aakashvishcoder/fpgacarrierboard/bom_handsolder.csv

Qty | Value | Designator | Footprint | LCSC Part # (if any)
7 | 10uF | C1,C2,C3,C4,C21,C107,C108 | CP_Radial_D5.0mm_P2.00mm | C47344176
6 | 100nF | C5,C6,C7,C8,C22,C85 | C_Disc_D3.0mm_W2.0mm_P2.50mm | C5632430
4 | 3.3nF | C9,C10,C11,C12 | C_Disc_D3.0mm_W2.0mm_P2.50mm | C511575
8 | 22uF | C13,C14,C15,C16,C17,C18,C19,C20 | CP_Radial_D6.3mm_P2.50mm | C2835673
1 | 1nF | C23 | C_Disc_D3.0mm_W2.0mm_P2.50mm | C1624895
5 | 0.1uF | C88,C89,C106,C109,C110 | C_Disc_D3.0mm_W2.0mm_P2.50mm | C5632430
1 | 1uF | C90 | C_Disc_D3.0mm_W2.0mm_P2.50mm | C1646109
6 | LED | D1,D3,D4,D5,D6,D7 | LED_D3.0mm
1 | D_Zener | D2 | D_DO-41_SOD81_P10.16mm_Horizontal
1 | Polyfuse | F1 | FUSE-TH_L9.5-W3.5-P5.08-D0.8-S1.2
1 | Conn_01x06 | J1 | PinHeader_1x06_P2.54mm_Vertical
1 | HR911130C | J3 | RJ45-TH_HR911130C | C50933
1 | Conn_02x10_Odd_Even | J5 | PinHeader_2x10_P2.54mm_Vertical
1 | 2.49k | R1 | R_Axial_DIN0207_L6.3mm_D2.5mm_P10.16mm_Horizontal
5 | 10k | R2,R6,R39,R49,R50 | R_Axial_DIN0207_L6.3mm_D2.5mm_P10.16mm_Horizontal
1 | 24.9k | R3 | R_Axial_DIN0207_L6.3mm_D2.5mm_P10.16mm_Horizontal
1 | 20k | R4 | R_Axial_DIN0207_L6.3mm_D2.5mm_P10.16mm_Horizontal
1 | 4.99k | R5 | R_Axial_DIN0207_L6.3mm_D2.5mm_P10.16mm_Horizontal
1 | 49.9k | R7 | R_Axial_DIN0207_L6.3mm_D2.5mm_P10.16mm_Horizontal
1 | 16k | R8 | R_Axial_DIN0207_L6.3mm_D2.5mm_P10.16mm_Horizontal
6 | 100k | R9,R10,R11,R12,R15,R16 | R_Axial_DIN0207_L6.3mm_D2.5mm_P10.16mm_Horizontal
2 | 5.1k | R13,R14 | R_Axial_DIN0207_L6.3mm_D2.5mm_P10.16mm_Horizontal
19 | 4.7k | R18,R19,R20,R21,R22,R30,R31,R32,R33,R34,R35,R36,R37,R38,R40,R41,R42,R43,R44 | R_Axial_DIN0207_L6.3mm_D2.5mm_P10.16mm_Horizontal
4 | 1k | R23,R24,R25,R51 | R_Axial_DIN0207_L6.3mm_D2.5mm_P10.16mm_Horizontal
1 | 33 | R26 | R_Axial_DIN0207_L6.3mm_D2.5mm_P10.16mm_Horizontal
1 | 50 | R27 | R_Axial_DIN0207_L6.3mm_D2.5mm_P10.16mm_Horizontal
6 | 470 | R28,R45,R46,R47,R48,R53 | R_Axial_DIN0207_L6.3mm_D2.5mm_P10.16mm_Horizontal
1 | 330 | R52 | R_Axial_DIN0207_L6.3mm_D2.5mm_P10.16mm_Horizontal
3 | SW_Push | SW1,SW2,SW3 | SW_SPST_TL3342
