aakashvishcoder/fpgacarrierboard/bom_jlc.csv

Comment | Designator | Footprint | LCSC Part #
100uF | C24 | C_1210_3225Metric | C49066
47uF | C25,C26,C27,C28,C29 | C_1210_3225Metric | C2932477
4.7uF | C30,C31,C32,C33,C34,C35,C36,C37,C38,C39,C40,C41,C42,C43,C44,C45,C46,C103,C104,C105 | C_0805_2012Metric | C98195
0.47uF | C47,C48,C49,C50,C51,C52,C53,C54,C55,C56,C57,C58,C59,C60,C61,C62,C63,C64,C65,C66,C67,C68,C69,C70,C71,C72,C73,C74,C75,C76,C77,C78 | C_0603_1608Metric | C1623
4.7uF | C79,C80 | C_0603_1608Metric | C107368
0.1uF | C81,C82,C83,C84,C86,C87,C91,C92,C93,C94,C95,C96,C97,C98,C99,C100,C101,C102,C111,C112,C113,C114 | C_0603_1608Metric | C14663
FerriteBead | FB1,FB2,FB3,FB4,FB5,FB6,FB7 | L_0603_1608Metric | C19330
Conn_Coaxial | J2 | SMA_Amphenol_132134-10_Vertical | C2693814
SFPK-SL | J4 | SAMTEC_SFPK-SL | C20691304
2.2uH | L1,L2,L3,L4 | IND-SMD_L4.5-W4.1_SRP4020TA | C719179
OB2EL89CLIB112YLC-125M | OSC1 | OSC-SMD_6P-L3.2-W2.5-BL-1 | C7425465
100 | R17 | R_0603_1608Metric | C2906981
2.49k | R29 | R_0603_1608Metric | C2930072
TPS62130A | U1,U2,U3,U4 | VQFN-16-1EP_3x3mm_P0.5mm_EP1.68x1.68mm | C337502
TPS2592xx | U5 | VSON-10-1EP_3x3mm_P0.5mm_EP1.65x2.4mm | C527680
XC7A35T-FGG484 | U6 | Xilinx_FGG484 | C6934285
W25Q128JVS | U7 | SOIC-8_5.3x5.3mm_P1.27mm | C97521
RTL8211E-VB-CG | U8 | QFN-48_L6.0-W6.0-P0.40-BL-EP3.8 | C90735
TYPE-C 6P | USB1 | TYPE-C-SMD_TYPE-C-6P_1 | C456012
OT322550MJBA4SL | Y1 | OSC-SMD_4P-L3.2-W2.5-BL | C717684
OT322525MJBA4SL | Y3 | OSC-SMD_4P-L3.2-W2.5-BL | C669088
