aakashvishcoder/fpgacarrierboard/bom_cli.csv

Reference | Value | Footprint | Qty | LCSC
C1-C4,C21,C107,C108 | 10uF | Capacitor_THT:CP_Radial_D5.0mm_P2.00mm | 7 | C47344176
C5-C8,C22,C85 | 100nF | Capacitor_THT:C_Disc_D3.0mm_W2.0mm_P2.50mm | 6 | C5632430
C9-C12 | 3.3nF | Capacitor_THT:C_Disc_D3.0mm_W2.0mm_P2.50mm | 4 | C511575
C13-C20 | 22uF | Capacitor_THT:CP_Radial_D6.3mm_P2.50mm | 8 | C2835673
C23 | 1nF | Capacitor_THT:C_Disc_D3.0mm_W2.0mm_P2.50mm | 1 | C1624895
C24 | 100uF | Capacitor_SMD:C_1210_3225Metric | 1 | C49066
C25-C29 | 47uF | Capacitor_SMD:C_1210_3225Metric | 5 | C2932477
C30-C46,C103-C105 | 4.7uF | Capacitor_SMD:C_0805_2012Metric | 20 | C98195
C47-C78 | 0.47uF | Capacitor_SMD:C_0603_1608Metric | 32 | C1623
C79,C80 | 4.7uF | Capacitor_SMD:C_0603_1608Metric | 2 | C107368
C81-C84,C86,C87,C91-C102,C111-C114 | 0.1uF | Capacitor_SMD:C_0603_1608Metric | 22 | C14663
C88,C89,C106,C109,C110 | 0.1uF | Capacitor_THT:C_Disc_D3.0mm_W2.0mm_P2.50mm | 5 | C5632430
C90 | 1uF | Capacitor_THT:C_Disc_D3.0mm_W2.0mm_P2.50mm | 1 | C1646109
D1,D3-D6 | LED | LED_THT:LED_D3.0mm | 5
D2 | D_Zener | Diode_THT:D_DO-41_SOD81_P10.16mm_Horizontal | 1
F1 | Polyfuse | easyeda:FUSE-TH_L9.5-W3.5-P5.08-D0.8-S1.2 | 1
FB1-FB7 | FerriteBead | Inductor_SMD:L_0603_1608Metric | 7 | C19330
J1 | Conn_01x06 | Connector_PinHeader_2.54mm:PinHeader_1x06_P2.54mm_Vertical | 1
J2 | Conn_Coaxial | Connector_Coaxial:SMA_Amphenol_132134-10_Vertical | 1 | C2693814
J3 | HR911130C | easyeda:RJ45-TH_HR911130C | 1 | C50933
J4 | SFPK-SL | samtec:SAMTEC_SFPK-SL | 1 | C20691304
J5 | Conn_02x10_Odd_Even | Connector_PinHeader_2.54mm:PinHeader_2x10_P2.54mm_Vertical | 1
L1-L4 | 2.2uH | easyeda:IND-SMD_L4.5-W4.1_SRP4020TA | 4 | C719179
OSC1 | OB2EL89CLIB112YLC-125M | easyeda:OSC-SMD_6P-L3.2-W2.5-BL-1 | 1 | C7425465
R1 | 2.49k | Resistor_THT:R_Axial_DIN0207_L6.3mm_D2.5mm_P10.16mm_Horizontal | 1
R2,R6,R39,R49,R50 | 10k | Resistor_THT:R_Axial_DIN0207_L6.3mm_D2.5mm_P10.16mm_Horizontal | 5
R3 | 24.9k | Resistor_THT:R_Axial_DIN0207_L6.3mm_D2.5mm_P10.16mm_Horizontal | 1
R4 | 20k | Resistor_THT:R_Axial_DIN0207_L6.3mm_D2.5mm_P10.16mm_Horizontal | 1
R5 | 4.99k | Resistor_THT:R_Axial_DIN0207_L6.3mm_D2.5mm_P10.16mm_Horizontal | 1
R7 | 49.9k | Resistor_THT:R_Axial_DIN0207_L6.3mm_D2.5mm_P10.16mm_Horizontal | 1
R8 | 16k | Resistor_THT:R_Axial_DIN0207_L6.3mm_D2.5mm_P10.16mm_Horizontal | 1
R9-R12,R15,R16 | 100k | Resistor_THT:R_Axial_DIN0207_L6.3mm_D2.5mm_P10.16mm_Horizontal | 6
R13,R14 | 5.1k | Resistor_THT:R_Axial_DIN0207_L6.3mm_D2.5mm_P10.16mm_Horizontal | 2
R17 | 100 | Resistor_SMD:R_0603_1608Metric | 1 | C2906981
R18-R22,R30-R38,R40-R44,R51 | 4.7k | Resistor_THT:R_Axial_DIN0207_L6.3mm_D2.5mm_P10.16mm_Horizontal | 20
R23-R25 | 1k | Resistor_THT:R_Axial_DIN0207_L6.3mm_D2.5mm_P10.16mm_Horizontal | 3
R26 | 33 | Resistor_THT:R_Axial_DIN0207_L6.3mm_D2.5mm_P10.16mm_Horizontal | 1
R27 | 50 | Resistor_THT:R_Axial_DIN0207_L6.3mm_D2.5mm_P10.16mm_Horizontal | 1
R28,R45-R48 | 470 | Resistor_THT:R_Axial_DIN0207_L6.3mm_D2.5mm_P10.16mm_Horizontal | 5
R29 | 2.49k | Resistor_SMD:R_0603_1608Metric | 1 | C2930072
SW1-SW3 | SW_Push | Button_Switch_SMD:SW_SPST_TL3342 | 3
TP1 | 1V0_TP | TestPoint:TestPoint_THTPad_D1.5mm_Drill0.7mm | 1
TP2 | 1V8_TP | TestPoint:TestPoint_THTPad_D1.5mm_Drill0.7mm | 1
TP3 | 1V2_TP | TestPoint:TestPoint_THTPad_D1.5mm_Drill0.7mm | 1
TP4 | 3V3_TP | TestPoint:TestPoint_THTPad_D1.5mm_Drill0.7mm | 1
TP5 | TestPoint | TestPoint:TestPoint_THTPad_D1.5mm_Drill0.7mm | 1
U1-U4 | TPS62130A | Package_DFN_QFN:VQFN-16-1EP_3x3mm_P0.5mm_EP1.68x1.68mm | 4 | C337502
U5 | TPS2592xx | Package_SON:VSON-10-1EP_3x3mm_P0.5mm_EP1.65x2.4mm | 1 | C527680
U6 | XC7A35T-FGG484 | Package_BGA:Xilinx_FGG484 | 1 | C6934285
U7 | W25Q128JVS | Package_SO:SOIC-8_5.3x5.3mm_P1.27mm | 1 | C97521
U8 | RTL8211E-VB-CG | easyeda:QFN-48_L6.0-W6.0-P0.40-BL-EP3.8 | 1 | C90735
USB1 | TYPE-C 6P | easyeda:TYPE-C-SMD_TYPE-C-6P_1 | 1 | C456012
Y1 | OT322550MJBA4SL | easyeda:OSC-SMD_4P-L3.2-W2.5-BL | 1 | C717684
Y3 | OT322525MJBA4SL | easyeda:OSC-SMD_4P-L3.2-W2.5-BL | 1 | C669088
