aakashvishcoder/fpgacarrierboard/fpgacarrierboard.kicad_pcb

## KiCad design fpgacarrierboard.kicad_pcb (2026-10-16)

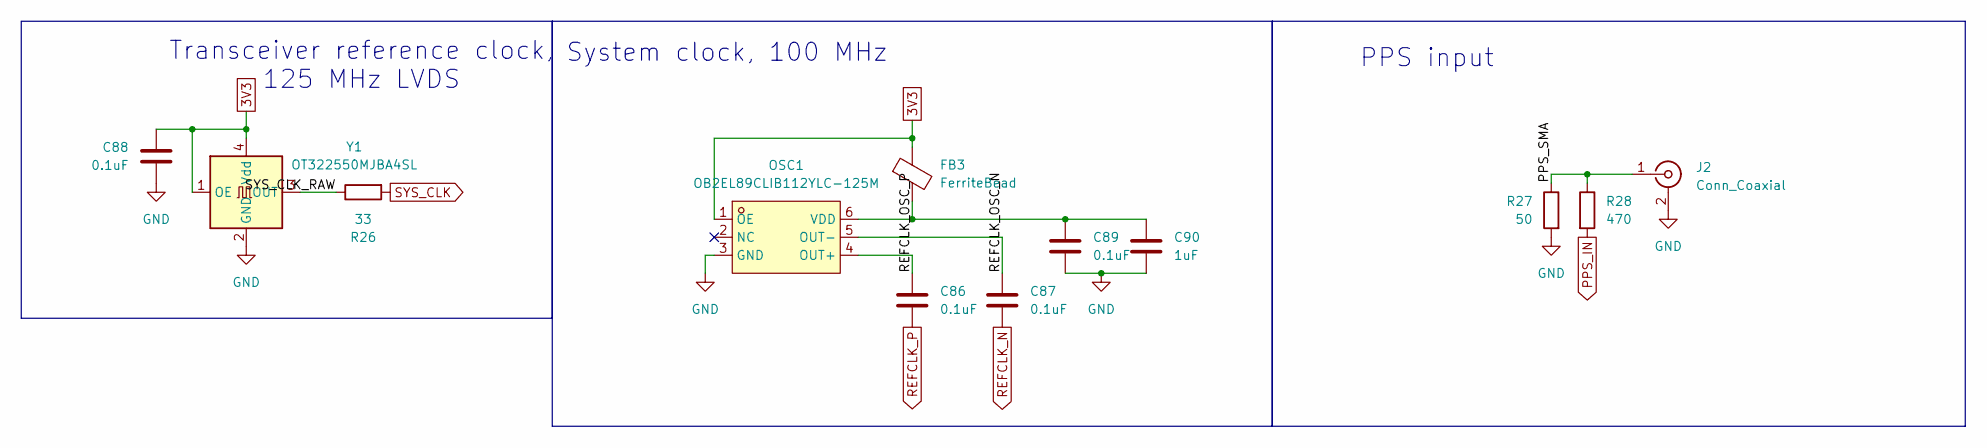
[picture p1: schematic clocks.kicad_sch]

Parts:
C86, C87: 0.1uF; C_0603_1608Metric; LCSC Part C14663
C88, C89: 0.1uF; C_Disc_D3.0mm_W2.0mm_P2.50mm; LCSC Part C5632430
C90: 1uF; C_Disc_D3.0mm_W2.0mm_P2.50mm; LCSC Part C1646109
FB3: FerriteBead; L_0603_1608Metric; LCSC Part C19330
J2: Conn_Coaxial; SMA_Amphenol_132134-10_Vertical; LCSC Part C2693814
OSC1: OB2EL89CLIB112YLC-125M; OSC-SMD_6P-L3.2-W2.5-BL-1; MPN OB2EL89CLIB112YLC-125M; LCSC Part C7425465
R26: 33; R_Axial_DIN0207_L6.3mm_D2.5mm_P10.16mm_Horizontal
R27: 50; R_Axial_DIN0207_L6.3mm_D2.5mm_P10.16mm_Horizontal
R28: 470; R_Axial_DIN0207_L6.3mm_D2.5mm_P10.16mm_Horizontal
Y1: OT322550MJBA4SL; OSC-SMD_4P-L3.2-W2.5-BL; LCSC Part C717684

Connections:
3V3: C88.1, FB3.1, OSC1.1 (OE), Y1.1 (OE), Y1.4 (Vdd); also elsewhere on the board
/Clocks/PPS_SMA: J2.1 (In), R27.1, R28.1
/Clocks/REFCLK_OSC_N: C87.1, OSC1.5 (OUT-)
/Clocks/REFCLK_OSC_P: C86.1, OSC1.4 (OUT+)
/Clocks/SYS_CLK_RAW: R26.1, Y1.3 (OUT)
GND: C88.2, C89.2, C90.2, J2.2 (Ext), OSC1.3 (GND), R27.2, Y1.2 (GND); also elsewhere on the board
unnamed: C89.1, C90.1, FB3.2, OSC1.6 (VDD)
PPS_IN: R28.2; also elsewhere on the board
REFCLK_N: C87.2; also elsewhere on the board
REFCLK_P: C86.2; also elsewhere on the board
SYS_CLK: R26.2; also elsewhere on the board

Notes on the sheet:
System clock, 100 MHz
PPS input
Transceiver reference clock, 125 MHz LVDS

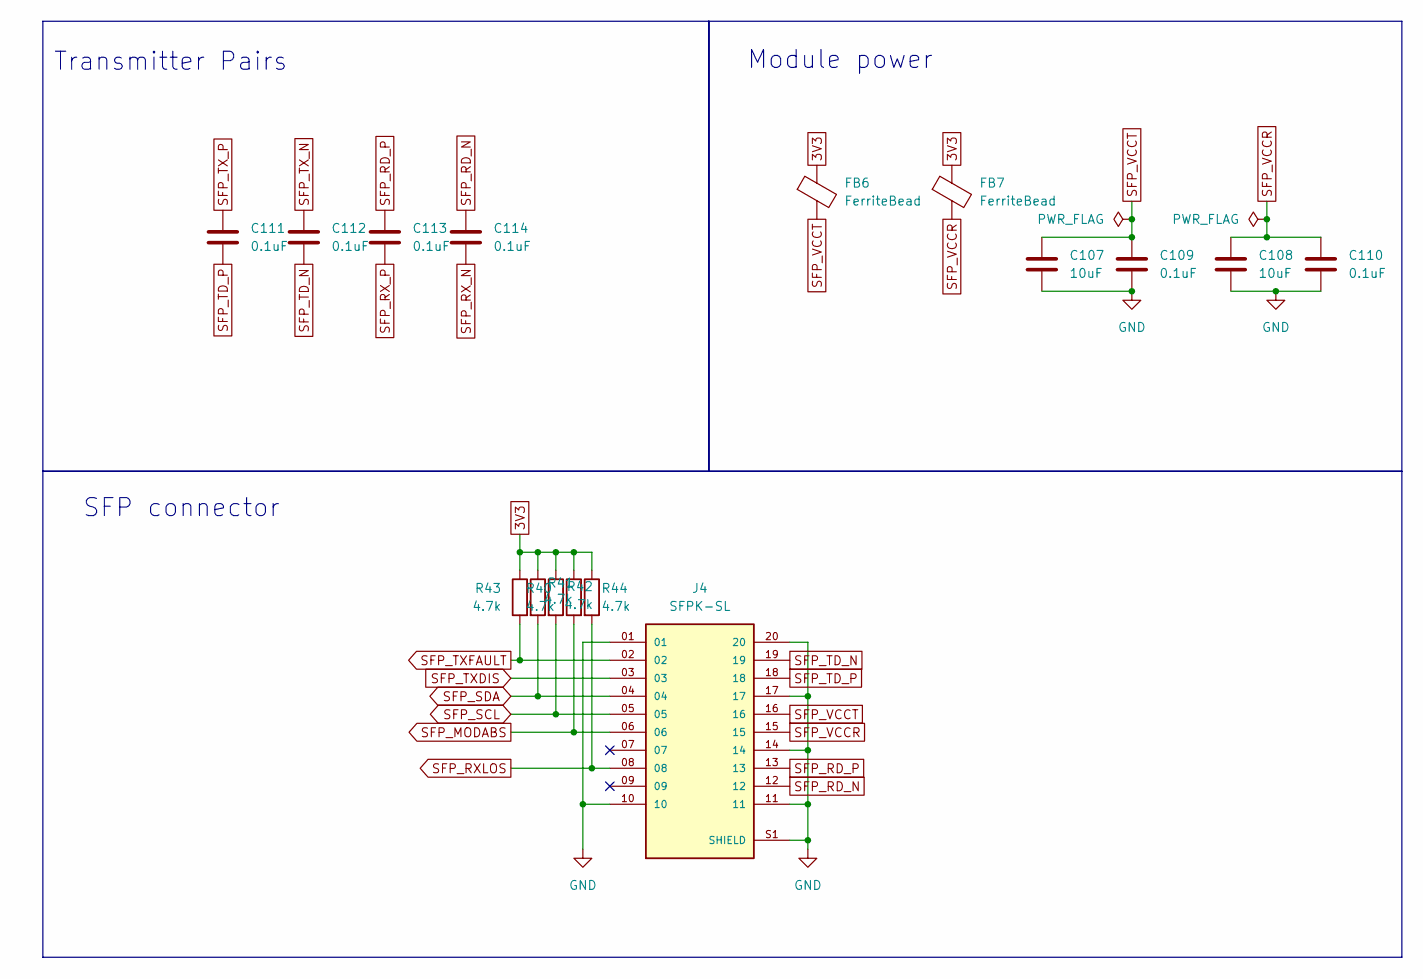
[picture p2: schematic sfplane.kicad_sch]

Parts:
C107, C108: 10uF; CP_Radial_D5.0mm_P2.00mm; LCSC Part C47344176
C109, C110: 0.1uF; C_Disc_D3.0mm_W2.0mm_P2.50mm; LCSC Part C5632430
C111, C112, C113, C114: 0.1uF; C_0603_1608Metric; LCSC Part C14663
FB6, FB7: FerriteBead; L_0603_1608Metric; LCSC Part C19330
J4: SFPK-SL; SAMTEC_SFPK-SL; PARTREV H; LCSC Part C20691304
R40, R41, R42, R43, R44: 4.7k; R_Axial_DIN0207_L6.3mm_D2.5mm_P10.16mm_Horizontal

Connections:
3V3: FB6.1, FB7.1, R40.1, R41.1, R42.1, R43.1, R44.1; also elsewhere on the board
GND: C107.2, C108.2, C109.2, C110.2, J4.01, J4.10, J4.11, J4.14, J4.17, J4.20, J4.S1 (SHIELD), J4.S2 (SHIELD), J4.S3 (SHIELD), J4.S4 (SHIELD), J4.S5 (SHIELD), J4.S6 (SHIELD), J4.S7 (SHIELD), J4.S8 (SHIELD), J4.S9 (SHIELD), J4.S10 (SHIELD), J4.S11 (SHIELD), J4.S12 (SHIELD), J4.S13 (SHIELD), J4.S14 (SHIELD), J4.S15 (SHIELD), J4.S16 (SHIELD), J4.S17 (SHIELD); also elsewhere on the board
SFP_MODABS: J4.06, R42.2; also elsewhere on the board
SFP_RD_N: C114.1, J4.12
SFP_RD_P: C113.1, J4.13
SFP_RXLOS: J4.08, R44.2; also elsewhere on the board
SFP_RX_N: C114.2; also elsewhere on the board
SFP_RX_P: C113.2; also elsewhere on the board
SFP_SCL: J4.05, R41.2; also elsewhere on the board
SFP_SDA: J4.04, R40.2; also elsewhere on the board
SFP_TD_N: C112.2, J4.19
SFP_TD_P: C111.2, J4.18
SFP_TXDIS: J4.03; also elsewhere on the board
SFP_TXFAULT: J4.02, R43.2; also elsewhere on the board
SFP_TX_N: C112.1; also elsewhere on the board
SFP_TX_P: C111.1; also elsewhere on the board
SFP_VCCR: C108.1, C110.1, FB7.2, J4.15
SFP_VCCT: C107.1, C109.1, FB6.2, J4.16

Notes on the sheet:
Transmitter Pairs
SFP connector
Module power

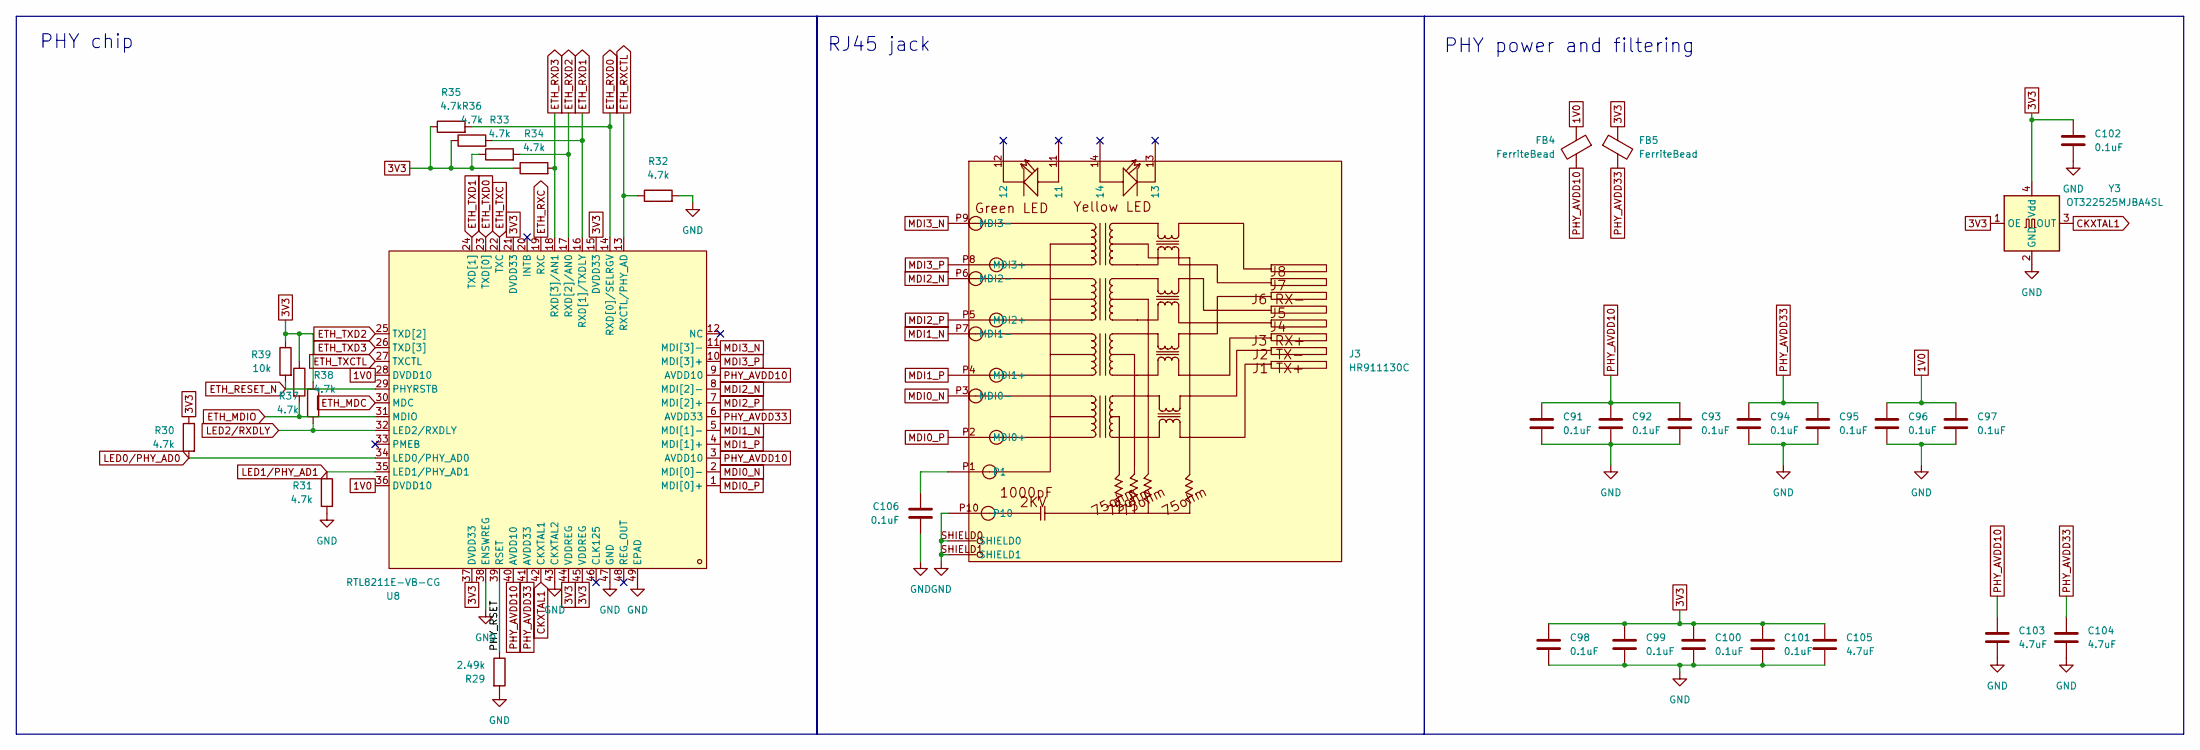
[picture p3: schematic ethernet1g.kicad_sch]

Parts:
C91, C92, C93, C94, C95, C96, C97, C98, C99, C100, C101, C102: 0.1uF; C_0603_1608Metric; LCSC Part C14663
C103, C104, C105: 4.7uF; C_0805_2012Metric; LCSC Part C98195
C106: 0.1uF; C_Disc_D3.0mm_W2.0mm_P2.50mm; LCSC Part C5632430
FB4, FB5: FerriteBead; L_0603_1608Metric; LCSC Part C19330
J3: HR911130C; RJ45-TH_HR911130C; MPN HR911130C; LCSC Part C50933
R29: 2.49k; R_0603_1608Metric; LCSC Part C2930072
R30, R31, R32, R33, R34, R35, R36, R37, R38: 4.7k; R_Axial_DIN0207_L6.3mm_D2.5mm_P10.16mm_Horizontal
R39: 10k; R_Axial_DIN0207_L6.3mm_D2.5mm_P10.16mm_Horizontal
U8: RTL8211E-VB-CG; QFN-48_L6.0-W6.0-P0.40-BL-EP3.8; MPN RTL8211E-VB-CG; LCSC Part C90735
Y3: OT322525MJBA4SL; OSC-SMD_4P-L3.2-W2.5-BL; LCSC Part C669088

Connections:
1V0: C96.1, C97.1, FB4.1, U8.28 (DVDD10), U8.36 (DVDD10); also elsewhere on the board
3V3: C98.1, C99.1, C100.1, C101.1, C102.1, C105.1, FB5.1, R30.1, R33.1, R34.1, R35.1, R36.1, R37.1, R38.1, R39.1, U8.15 (DVDD33), U8.21 (DVDD33), U8.37 (DVDD33), U8.44 (VDDREG), U8.45 (VDDREG), Y3.1 (OE), Y3.4 (Vdd); also elsewhere on the board
/Ethernet_1G/PHY_RSET: R29.1, U8.39 (RSET)
CKXTAL1: U8.42 (CKXTAL1), Y3.3 (OUT)
ETH_MDC: U8.30 (MDC); also elsewhere on the board
ETH_MDIO: R38.2, U8.31 (MDIO); also elsewhere on the board
ETH_RESET_N: R39.2, U8.29 (PHYRSTB); also elsewhere on the board
ETH_RXC: U8.19 (RXC); also elsewhere on the board
ETH_RXCTL: R32.1, U8.13 (RXCTL/PHY_AD); also elsewhere on the board
ETH_RXD0: R35.2, U8.14 (RXD[0]/SELRGV); also elsewhere on the board
ETH_RXD1: R36.2, U8.16 (RXD[1]/TXDLY); also elsewhere on the board
ETH_RXD2: R33.2, U8.17 (RXD[2]/AN0); also elsewhere on the board
ETH_RXD3: R34.2, U8.18 (RXD[3]/AN1); also elsewhere on the board
ETH_TXC: U8.22 (TXC); also elsewhere on the board
ETH_TXCTL: U8.27 (TXCTL); also elsewhere on the board
ETH_TXD0: U8.23 (TXD[0]); also elsewhere on the board
ETH_TXD1: U8.24 (TXD[1]); also elsewhere on the board
ETH_TXD2: U8.25 (TXD[2]); also elsewhere on the board
ETH_TXD3: U8.26 (TXD[3]); also elsewhere on the board
GND: C91.2, C92.2, C93.2, C94.2, C95.2, C96.2, C97.2, C98.2, C99.2, C100.2, C101.2, C102.2, C103.2, C104.2, C105.2, C106.2, J3.P10, J3.SHIELD0, J3.SHIELD1, R29.2, R31.2, R32.2, U8.38 (ENSWREG), U8.43 (CKXTAL2), U8.47 (GND), U8.49 (EPAD), Y3.2 (GND); also elsewhere on the board
LED0/PHY_AD0: R30.2, U8.34 (LED0/PHY_AD0)
LED1/PHY_AD1: R31.1, U8.35 (LED1/PHY_AD1)
LED2/RXDLY: R37.2, U8.32 (LED2/RXDLY)
MDI0_N: J3.P3 (MDI0-), U8.2 (MDI[0]-)
MDI0_P: J3.P2 (MDI0+), U8.1 (MDI[0]+)
MDI1_N: J3.P7 (MDI1-), U8.5 (MDI[1]-)
MDI1_P: J3.P4 (MDI1+), U8.4 (MDI[1]+)
MDI2_N: J3.P6 (MDI2-), U8.8 (MDI[2]-)
MDI2_P: J3.P5 (MDI2+), U8.7 (MDI[2]+)
MDI3_N: J3.P9 (MDI3-), U8.11 (MDI[3]-)
MDI3_P: J3.P8 (MDI3+), U8.10 (MDI[3]+)
unnamed: C106.1, J3.P1
PHY_AVDD10: C91.1, C92.1, C93.1, C103.1, FB4.2, U8.3 (AVDD10), U8.9 (AVDD10), U8.40 (AVDD10)
PHY_AVDD33: C94.1, C95.1, C104.1, FB5.2, U8.6 (AVDD33), U8.41 (AVDD33)

Notes on the sheet:
PHY chip
PHY power and filtering
RJ45 jack

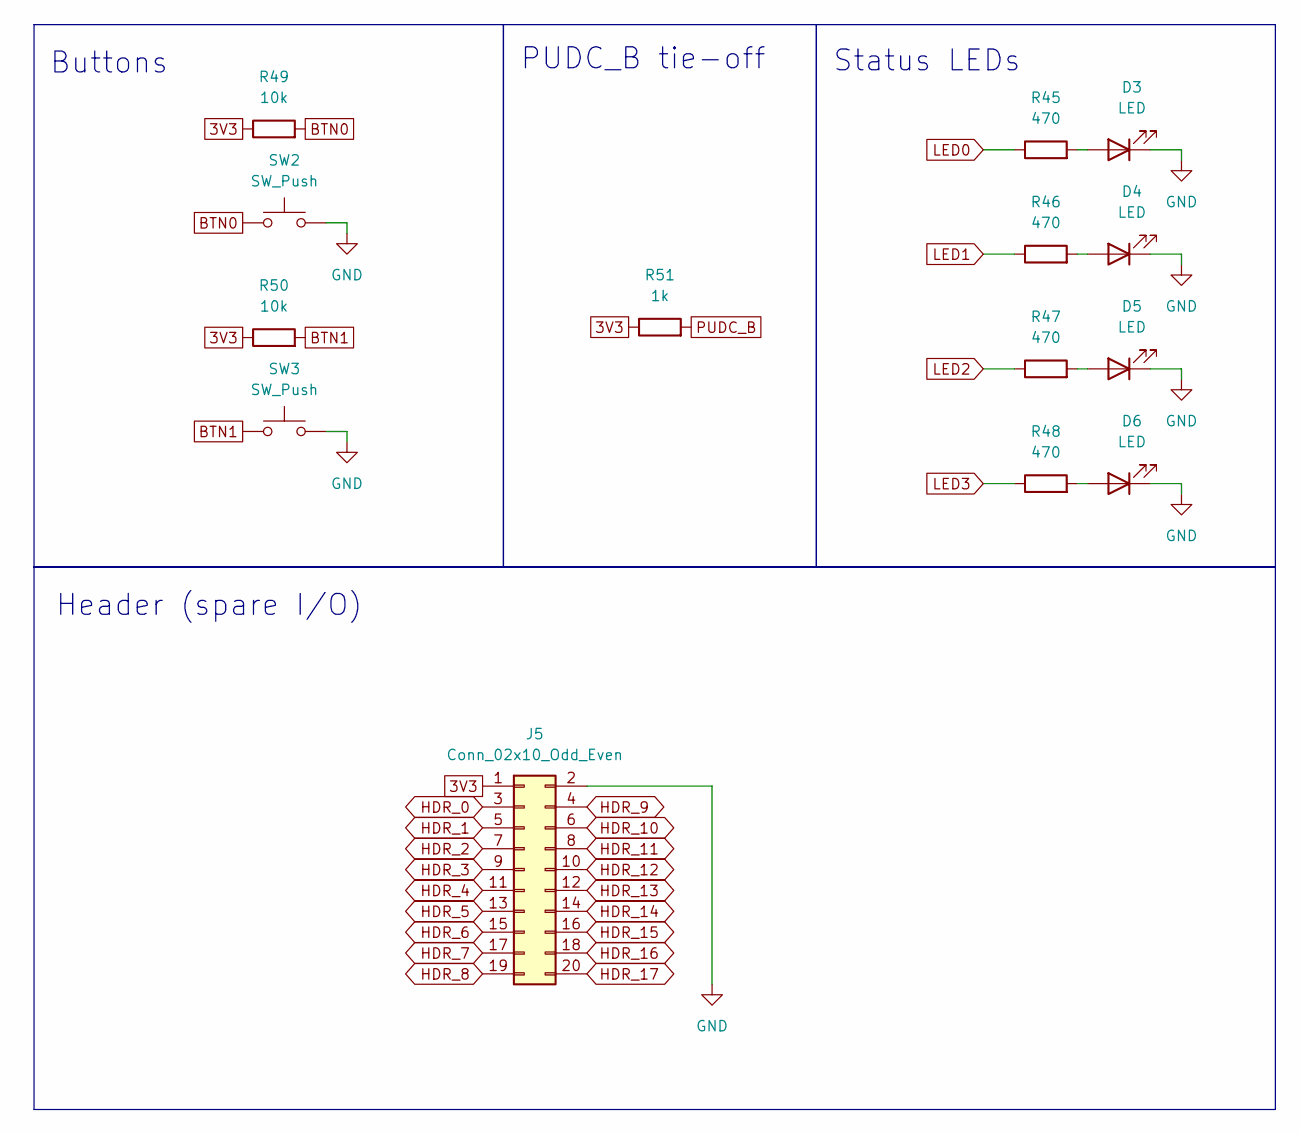
[picture p4: schematic iobreakout.kicad_sch]

Parts:
D3, D4, D5, D6: LED; LED_D3.0mm
J5: Conn_02x10_Odd_Even; PinHeader_2x10_P2.54mm_Vertical
R45, R46, R47, R48: 470; R_Axial_DIN0207_L6.3mm_D2.5mm_P10.16mm_Horizontal
R49, R50: 10k; R_Axial_DIN0207_L6.3mm_D2.5mm_P10.16mm_Horizontal
R51: 1k; R_Axial_DIN0207_L6.3mm_D2.5mm_P10.16mm_Horizontal
SW2, SW3: SW_Push; SW_SPST_TL3342

Connections:
3V3: J5.1, R49.1, R50.1, R51.1; also elsewhere on the board
BTN0: R49.2, SW2.1; also elsewhere on the board
BTN1: R50.2, SW3.1; also elsewhere on the board
GND: D3.1 (K), D4.1 (K), D5.1 (K), D6.1 (K), J5.2, SW2.2, SW3.2; also elsewhere on the board
HDR_0: J5.3; also elsewhere on the board
HDR_1: J5.5; also elsewhere on the board
HDR_2: J5.7; also elsewhere on the board
HDR_3: J5.9; also elsewhere on the board
HDR_4: J5.11; also elsewhere on the board
HDR_5: J5.13; also elsewhere on the board
HDR_6: J5.15; also elsewhere on the board
HDR_7: J5.17; also elsewhere on the board
HDR_8: J5.19; also elsewhere on the board
HDR_9: J5.4; also elsewhere on the board
HDR_10: J5.6; also elsewhere on the board
HDR_11: J5.8; also elsewhere on the board
HDR_12: J5.10; also elsewhere on the board
HDR_13: J5.12; also elsewhere on the board
HDR_14: J5.14; also elsewhere on the board
HDR_15: J5.16; also elsewhere on the board
HDR_16: J5.18; also elsewhere on the board
HDR_17: J5.20; also elsewhere on the board
LED0: R45.1; also elsewhere on the board
LED1: R46.1; also elsewhere on the board
LED2: R47.1; also elsewhere on the board
LED3: R48.1; also elsewhere on the board
unnamed: D3.2 (A), R45.2
unnamed: D4.2 (A), R46.2
unnamed: D5.2 (A), R47.2
unnamed: D6.2 (A), R48.2
PUDC_B: R51.2; also elsewhere on the board

Notes on the sheet:
Buttons
PUDC_B tie-off
Status LEDs
Header (spare I/O)

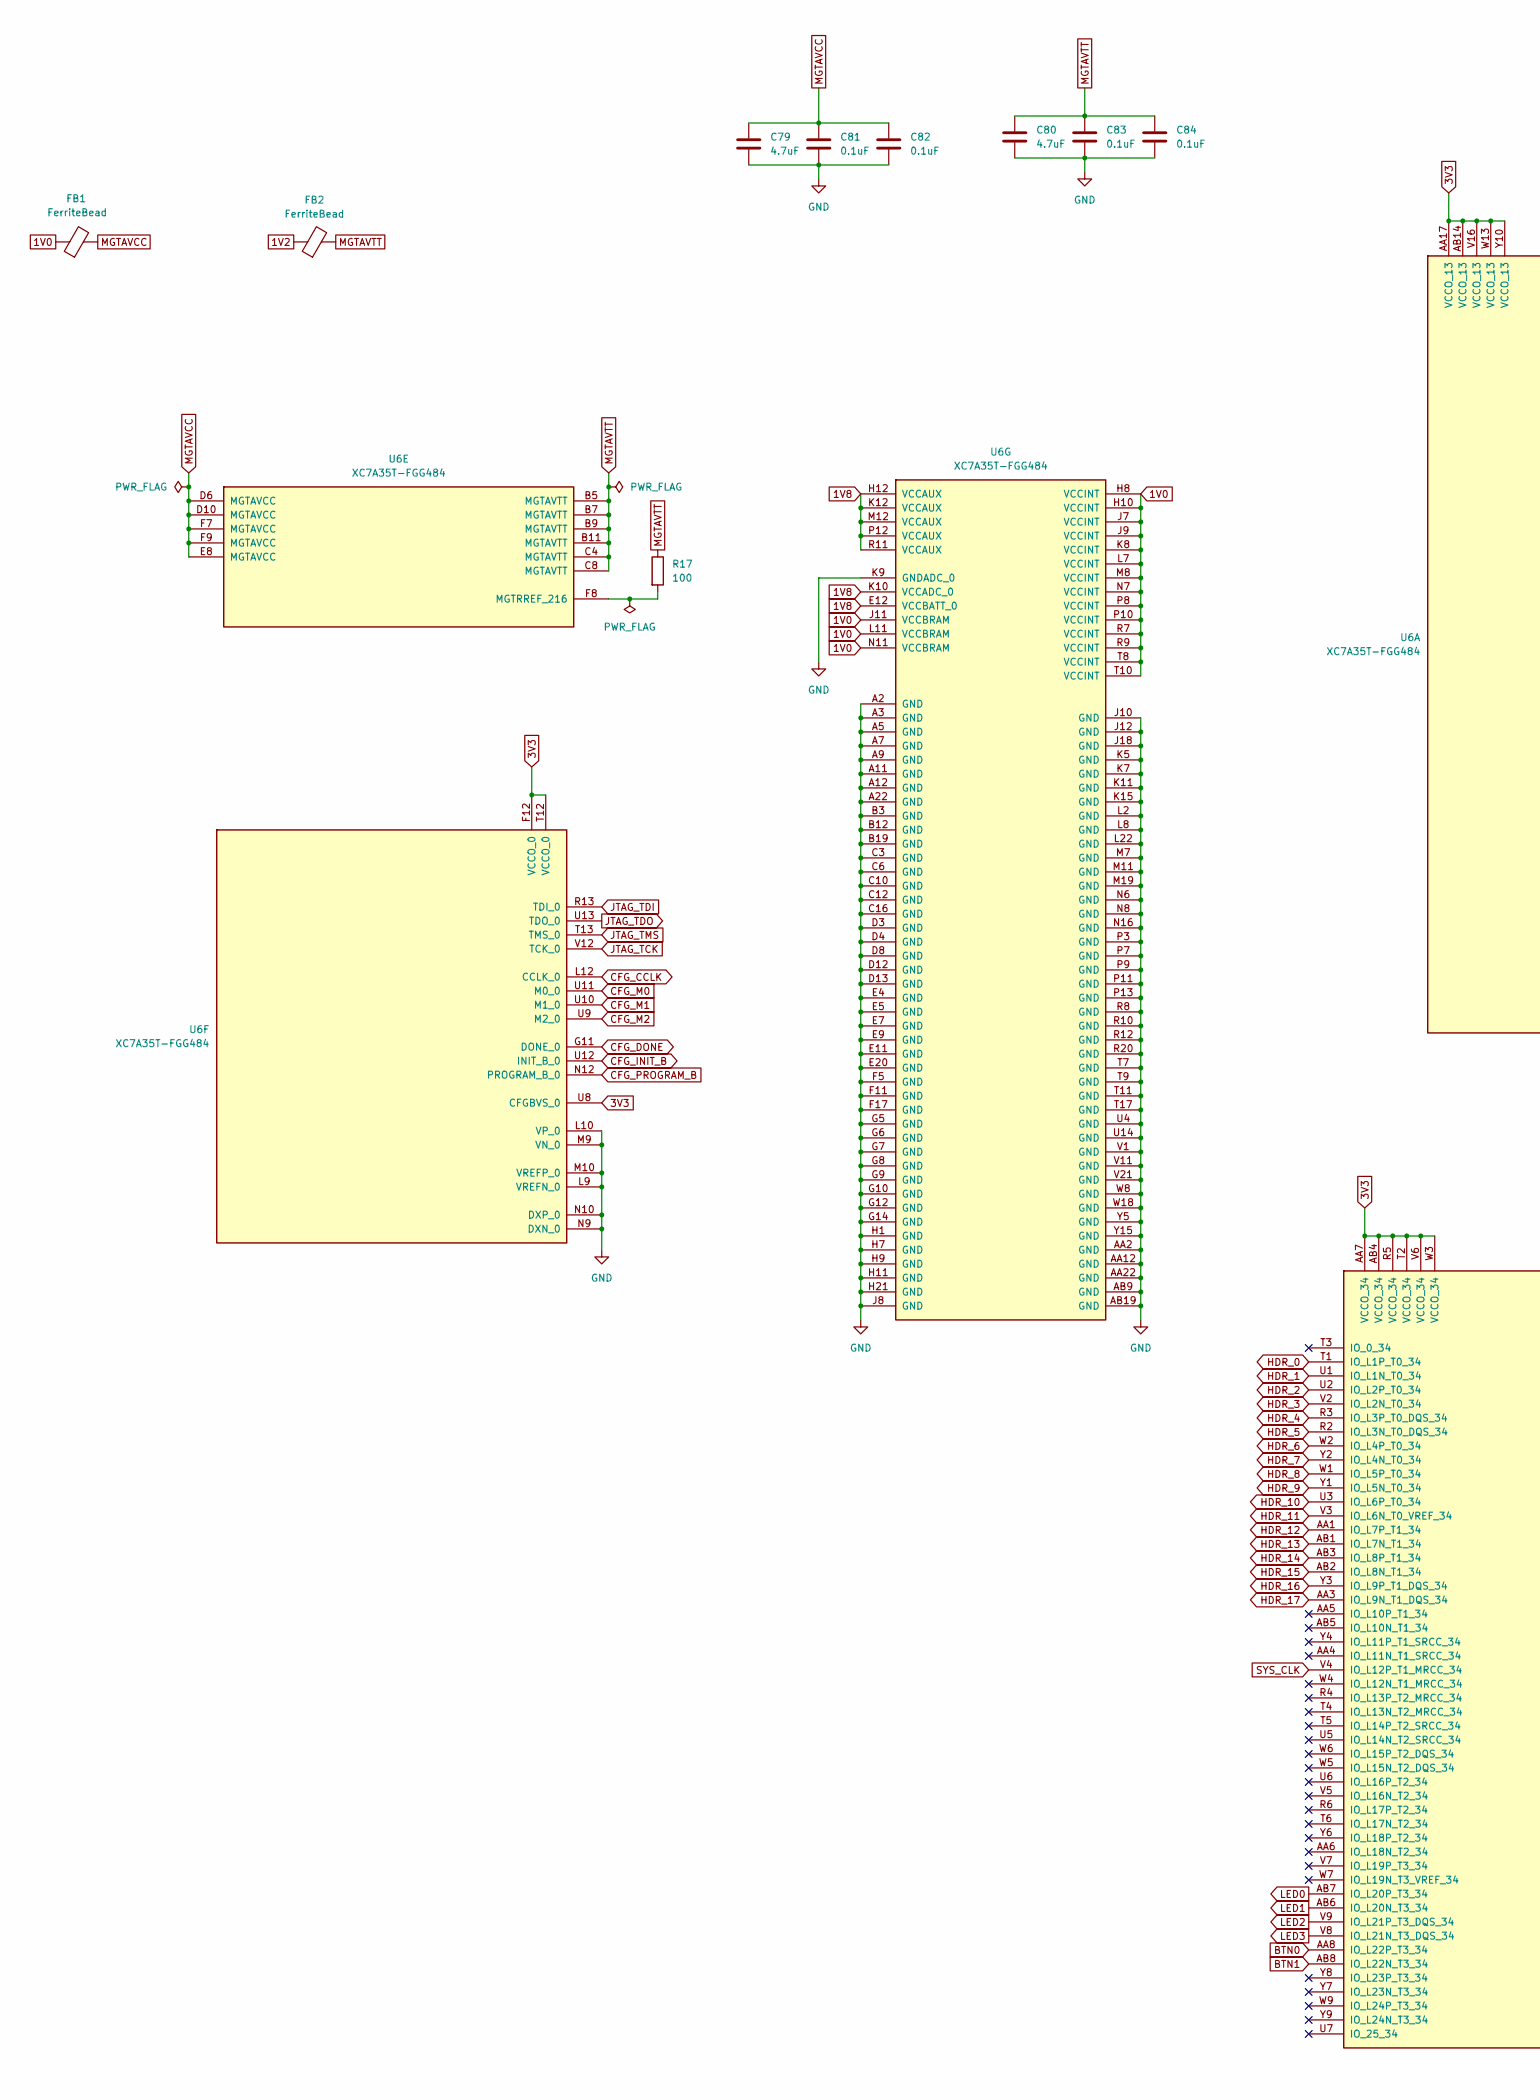
[picture p5: schematic fpgacore.kicad_sch, part in row 1, column 1]

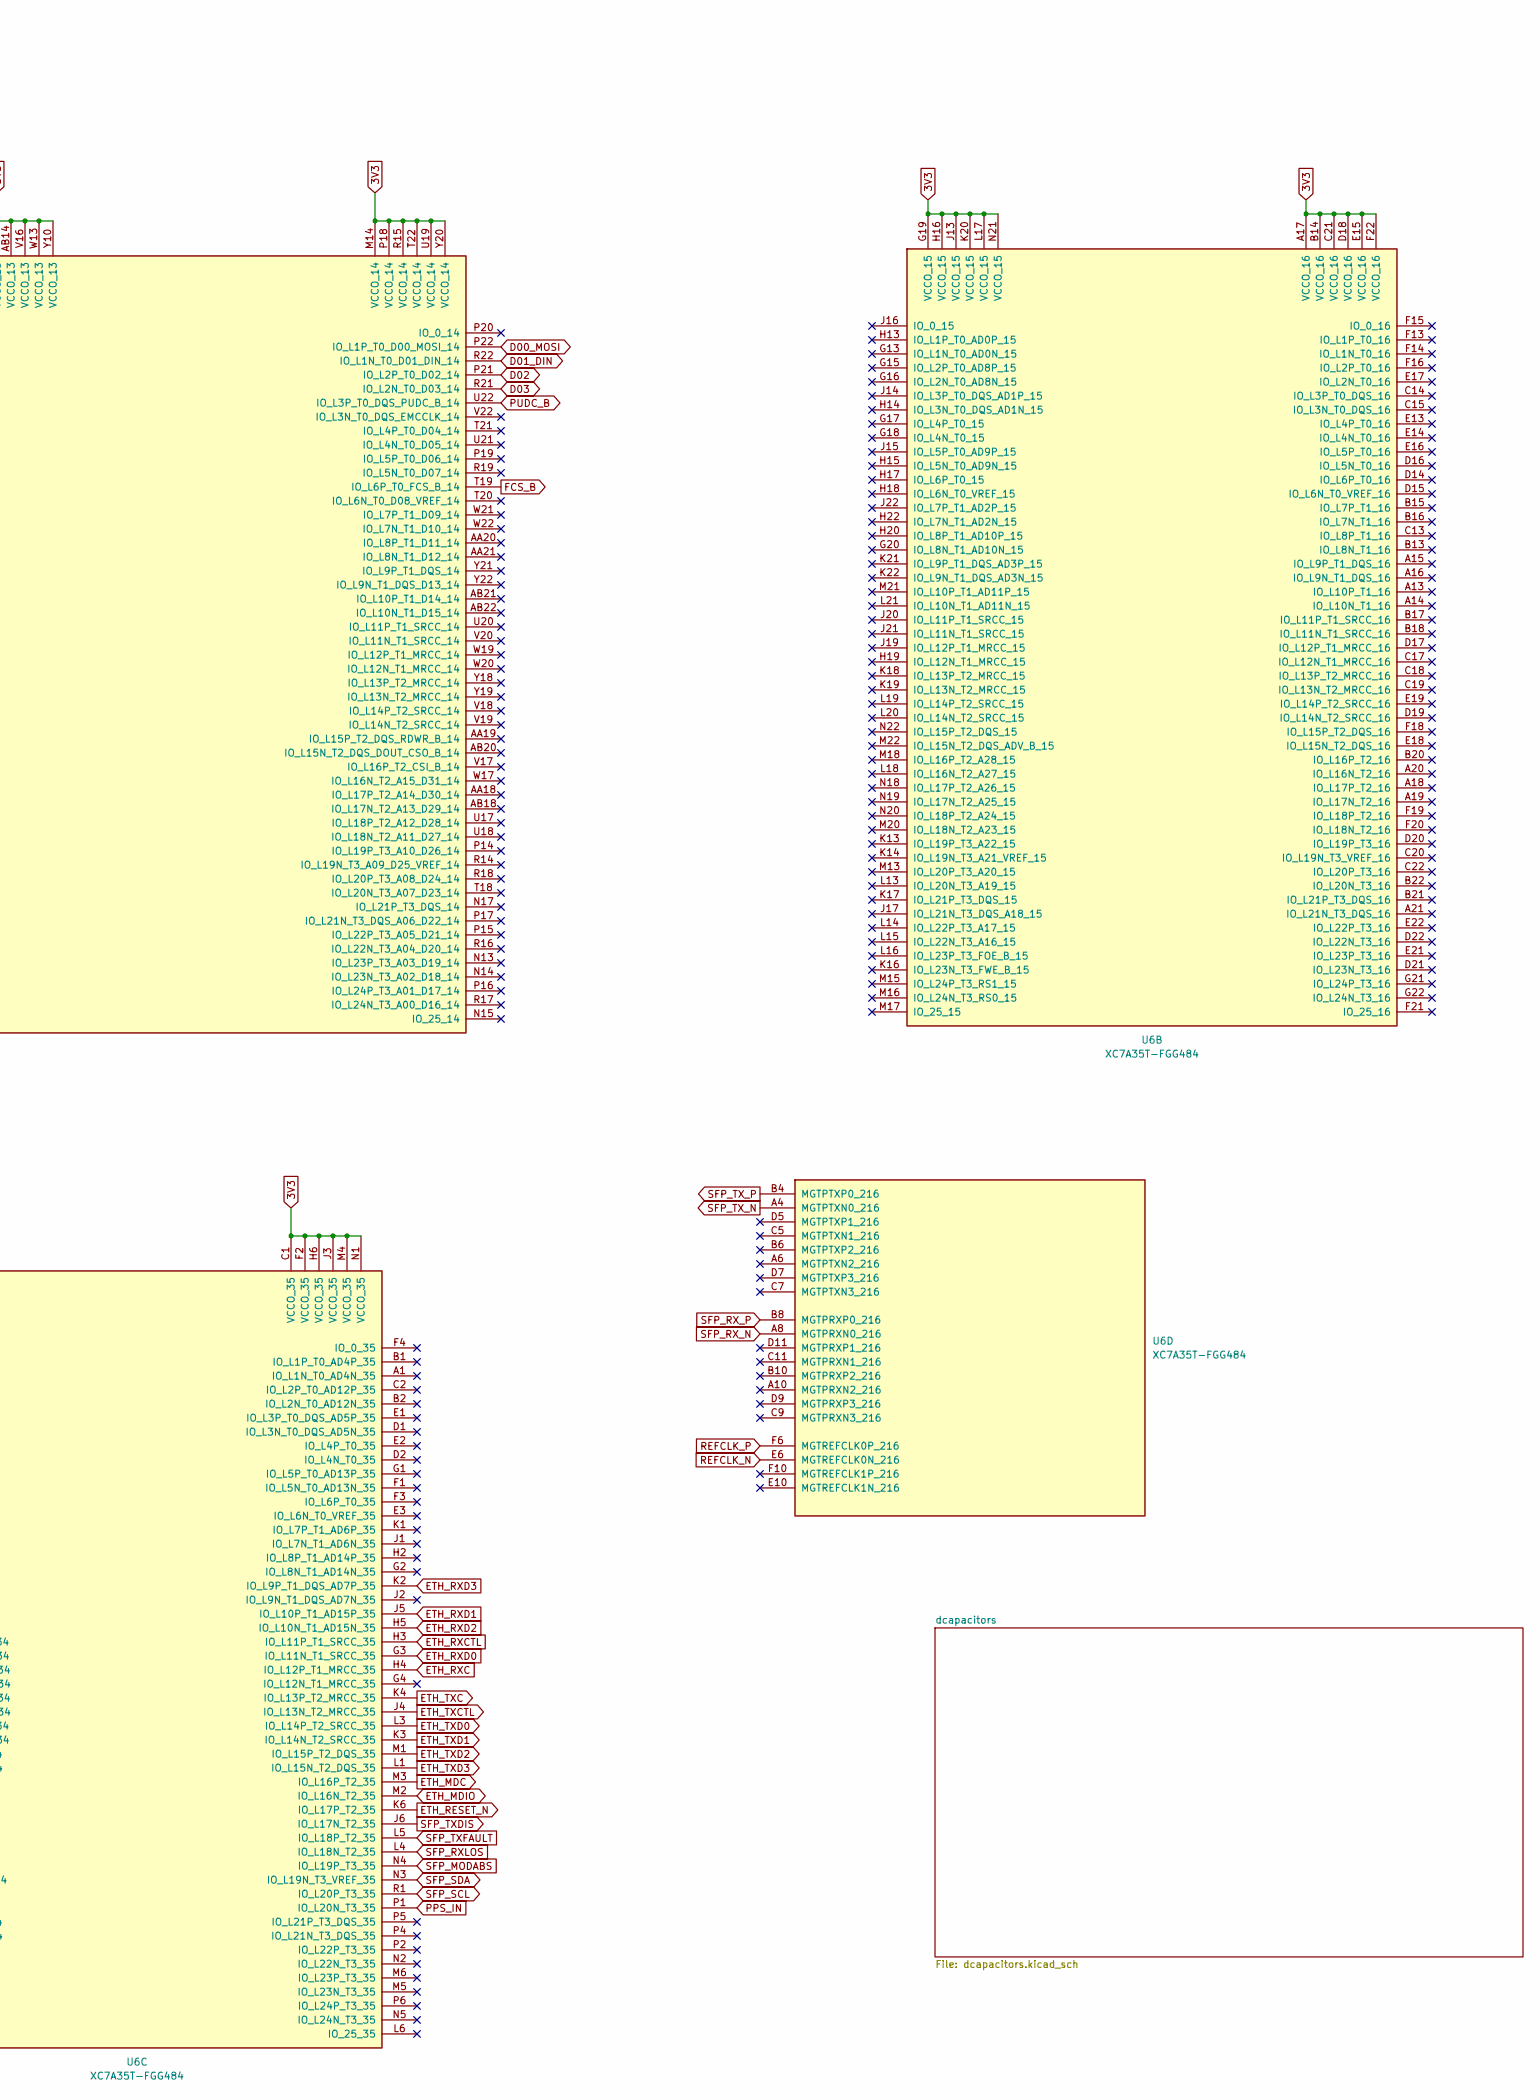
[picture p6: schematic fpgacore.kicad_sch, part in row 1, column 2]

Parts:
C79, C80: 4.7uF; C_0603_1608Metric; LCSC Part C107368
C81, C82, C83, C84: 0.1uF; C_0603_1608Metric; LCSC Part C14663
FB1, FB2: FerriteBead; L_0603_1608Metric; LCSC Part C19330
R17: 100; R_0603_1608Metric; LCSC Part C2906981
U6: XC7A35T-FGG484; Xilinx_FGG484; LCSC Part C6934285

Connections:
1V0: FB1.1, U6.H8 (VCCINT), U6.H10 (VCCINT), U6.J7 (VCCINT), U6.J9 (VCCINT), U6.J11 (VCCBRAM), U6.K8 (VCCINT), U6.L7 (VCCINT), U6.L11 (VCCBRAM), U6.M8 (VCCINT), U6.N7 (VCCINT), U6.N11 (VCCBRAM), U6.P8 (VCCINT), U6.P10 (VCCINT), U6.R7 (VCCINT), U6.R9 (VCCINT), U6.T8 (VCCINT), U6.T10 (VCCINT); also elsewhere on the board
1V2: FB2.1; also elsewhere on the board
1V8: U6.E12 (VCCBATT_0), U6.H12 (VCCAUX), U6.K10 (VCCADC_0), U6.K12 (VCCAUX), U6.M12 (VCCAUX), U6.P12 (VCCAUX), U6.R11 (VCCAUX); also elsewhere on the board
3V3: U6.A17 (VCCO_16), U6.AA7 (VCCO_34), U6.AA17 (VCCO_13), U6.AB4 (VCCO_34), U6.AB14 (VCCO_13), U6.B14 (VCCO_16), U6.C1 (VCCO_35), U6.C21 (VCCO_16), U6.D18 (VCCO_16), U6.E15 (VCCO_16), U6.F2 (VCCO_35), U6.F12 (VCCO_0), U6.F22 (VCCO_16), U6.G19 (VCCO_15), U6.H6 (VCCO_35), U6.H16 (VCCO_15), U6.J3 (VCCO_35), U6.J13 (VCCO_15), U6.K20 (VCCO_15), U6.L17 (VCCO_15), U6.M4 (VCCO_35), U6.M14 (VCCO_14), U6.N1 (VCCO_35), U6.N21 (VCCO_15), U6.P18 (VCCO_14), U6.R5 (VCCO_34), U6.R15 (VCCO_14), U6.T2 (VCCO_34), U6.T12 (VCCO_0), U6.T22 (VCCO_14), U6.U8 (CFGBVS_0), U6.U19 (VCCO_14), U6.V6 (VCCO_34), U6.V16 (VCCO_13), U6.W3 (VCCO_34), U6.W13 (VCCO_13), U6.Y10 (VCCO_13), U6.Y20 (VCCO_14); also elsewhere on the board
BTN0: U6.AA8 (IO_L22P_T3_34); also elsewhere on the board
BTN1: U6.AB8 (IO_L22N_T3_34); also elsewhere on the board
CFG_CCLK: U6.L12 (CCLK_0); also elsewhere on the board
CFG_DONE: U6.G11 (DONE_0); also elsewhere on the board
CFG_INIT_B: U6.U12 (INIT_B_0); also elsewhere on the board
CFG_M0: U6.U11 (M0_0); also elsewhere on the board
CFG_M1: U6.U10 (M1_0); also elsewhere on the board
CFG_M2: U6.U9 (M2_0); also elsewhere on the board
CFG_PROGRAM_B: U6.N12 (PROGRAM_B_0); also elsewhere on the board
D00_MOSI: U6.P22 (IO_L1P_T0_D00_MOSI_14); also elsewhere on the board
D01_DIN: U6.R22 (IO_L1N_T0_D01_DIN_14); also elsewhere on the board
D02: U6.P21 (IO_L2P_T0_D02_14); also elsewhere on the board
D03: U6.R21 (IO_L2N_T0_D03_14); also elsewhere on the board
ETH_MDC: U6.M3 (IO_L16P_T2_35); also elsewhere on the board
ETH_MDIO: U6.M2 (IO_L16N_T2_35); also elsewhere on the board
ETH_RESET_N: U6.K6 (IO_L17P_T2_35); also elsewhere on the board
ETH_RXC: U6.H4 (IO_L12P_T1_MRCC_35); also elsewhere on the board
ETH_RXCTL: U6.H3 (IO_L11P_T1_SRCC_35); also elsewhere on the board
ETH_RXD0: U6.G3 (IO_L11N_T1_SRCC_35); also elsewhere on the board
ETH_RXD1: U6.J5 (IO_L10P_T1_AD15P_35); also elsewhere on the board
ETH_RXD2: U6.H5 (IO_L10N_T1_AD15N_35); also elsewhere on the board
ETH_RXD3: U6.K2 (IO_L9P_T1_DQS_AD7P_35); also elsewhere on the board
ETH_TXC: U6.K4 (IO_L13P_T2_MRCC_35); also elsewhere on the board
ETH_TXCTL: U6.J4 (IO_L13N_T2_MRCC_35); also elsewhere on the board
ETH_TXD0: U6.L3 (IO_L14P_T2_SRCC_35); also elsewhere on the board
ETH_TXD1: U6.K3 (IO_L14N_T2_SRCC_35); also elsewhere on the board
ETH_TXD2: U6.M1 (IO_L15P_T2_DQS_35); also elsewhere on the board
ETH_TXD3: U6.L1 (IO_L15N_T2_DQS_35); also elsewhere on the board
FCS_B: U6.T19 (IO_L6P_T0_FCS_B_14); also elsewhere on the board
GND: C79.2, C80.2, C81.2, C82.2, C83.2, C84.2, U6.A2 (GND), U6.A3 (GND), U6.A5 (GND), U6.A7 (GND), U6.A9 (GND), U6.A11 (GND), U6.A12 (GND), U6.A22 (GND), U6.AA2 (GND), U6.AA12 (GND), U6.AA22 (GND), U6.AB9 (GND), U6.AB19 (GND), U6.B3 (GND), U6.B12 (GND), U6.B19 (GND), U6.C3 (GND), U6.C6 (GND), U6.C10 (GND), U6.C12 (GND), U6.C16 (GND), U6.D3 (GND), U6.D4 (GND), U6.D8 (GND), U6.D12 (GND), U6.D13 (GND), U6.E4 (GND), U6.E5 (GND), U6.E7 (GND), U6.E9 (GND), U6.E11 (GND), U6.E20 (GND), U6.F5 (GND), U6.F11 (GND), U6.F17 (GND), U6.G5 (GND), U6.G6 (GND), U6.G7 (GND), U6.G8 (GND), U6.G9 (GND), U6.G10 (GND), U6.G12 (GND), U6.G14 (GND), U6.H1 (GND), U6.H7 (GND), U6.H9 (GND), U6.H11 (GND), U6.H21 (GND), U6.J8 (GND), U6.J10 (GND), U6.J12 (GND), U6.J18 (GND), U6.K5 (GND), U6.K7 (GND), U6.K9 (GNDADC_0), U6.K11 (GND), U6.K15 (GND), U6.L2 (GND), U6.L8 (GND), U6.L9 (VREFN_0), U6.L10 (VP_0), U6.L22 (GND), U6.M7 (GND), U6.M9 (VN_0), U6.M10 (VREFP_0), U6.M11 (GND), U6.M19 (GND), U6.N6 (GND), U6.N8 (GND), U6.N9 (DXN_0), U6.N10 (DXP_0), U6.N16 (GND), U6.P3 (GND), U6.P7 (GND), U6.P9 (GND), U6.P11 (GND), U6.P13 (GND), U6.R8 (GND), U6.R10 (GND), U6.R12 (GND), U6.R20 (GND), U6.T7 (GND), U6.T9 (GND), U6.T11 (GND), U6.T17 (GND), U6.U4 (GND), U6.U14 (GND), U6.V1 (GND), U6.V11 (GND), U6.V21 (GND), U6.W8 (GND), U6.W18 (GND), U6.Y5 (GND), U6.Y15 (GND); also elsewhere on the board
HDR_0: U6.T1 (IO_L1P_T0_34); also elsewhere on the board
HDR_1: U6.U1 (IO_L1N_T0_34); also elsewhere on the board
HDR_2: U6.U2 (IO_L2P_T0_34); also elsewhere on the board
HDR_3: U6.V2 (IO_L2N_T0_34); also elsewhere on the board
HDR_4: U6.R3 (IO_L3P_T0_DQS_34); also elsewhere on the board
HDR_5: U6.R2 (IO_L3N_T0_DQS_34); also elsewhere on the board
HDR_6: U6.W2 (IO_L4P_T0_34); also elsewhere on the board
HDR_7: U6.Y2 (IO_L4N_T0_34); also elsewhere on the board
HDR_8: U6.W1 (IO_L5P_T0_34); also elsewhere on the board
HDR_9: U6.Y1 (IO_L5N_T0_34); also elsewhere on the board
HDR_10: U6.U3 (IO_L6P_T0_34); also elsewhere on the board
HDR_11: U6.V3 (IO_L6N_T0_VREF_34); also elsewhere on the board
HDR_12: U6.AA1 (IO_L7P_T1_34); also elsewhere on the board
HDR_13: U6.AB1 (IO_L7N_T1_34); also elsewhere on the board
HDR_14: U6.AB3 (IO_L8P_T1_34); also elsewhere on the board
HDR_15: U6.AB2 (IO_L8N_T1_34); also elsewhere on the board
HDR_16: U6.Y3 (IO_L9P_T1_DQS_34); also elsewhere on the board
HDR_17: U6.AA3 (IO_L9N_T1_DQS_34); also elsewhere on the board
JTAG_TCK: U6.V12 (TCK_0); also elsewhere on the board
JTAG_TDI: U6.R13 (TDI_0); also elsewhere on the board
JTAG_TDO: U6.U13 (TDO_0); also elsewhere on the board
JTAG_TMS: U6.T13 (TMS_0); also elsewhere on the board
LED0: U6.AB7 (IO_L20P_T3_34); also elsewhere on the board
LED1: U6.AB6 (IO_L20N_T3_34); also elsewhere on the board
LED2: U6.V9 (IO_L21P_T3_DQS_34); also elsewhere on the board
LED3: U6.V8 (IO_L21N_T3_DQS_34); also elsewhere on the board
MGTAVCC: C79.1, C81.1, C82.1, FB1.2, U6.D6 (MGTAVCC), U6.D10 (MGTAVCC), U6.E8 (MGTAVCC), U6.F7 (MGTAVCC), U6.F9 (MGTAVCC)
MGTAVTT: C80.1, C83.1, C84.1, FB2.2, R17.1, U6.B5 (MGTAVTT), U6.B7 (MGTAVTT), U6.B9 (MGTAVTT), U6.B11 (MGTAVTT), U6.C4 (MGTAVTT), U6.C8 (MGTAVTT)
unnamed: R17.2, U6.F8 (MGTRREF_216)
PPS_IN: U6.P1 (IO_L20N_T3_35); also elsewhere on the board
PUDC_B: U6.U22 (IO_L3P_T0_DQS_PUDC_B_14); also elsewhere on the board
REFCLK_N: U6.E6 (MGTREFCLK0N_216); also elsewhere on the board
REFCLK_P: U6.F6 (MGTREFCLK0P_216); also elsewhere on the board
SFP_MODABS: U6.N4 (IO_L19P_T3_35); also elsewhere on the board
SFP_RXLOS: U6.L4 (IO_L18N_T2_35); also elsewhere on the board
SFP_RX_N: U6.A8 (MGTPRXN0_216); also elsewhere on the board
SFP_RX_P: U6.B8 (MGTPRXP0_216); also elsewhere on the board
SFP_SCL: U6.R1 (IO_L20P_T3_35); also elsewhere on the board
SFP_SDA: U6.N3 (IO_L19N_T3_VREF_35); also elsewhere on the board
SFP_TXDIS: U6.J6 (IO_L17N_T2_35); also elsewhere on the board
SFP_TXFAULT: U6.L5 (IO_L18P_T2_35); also elsewhere on the board
SFP_TX_N: U6.A4 (MGTPTXN0_216); also elsewhere on the board
SFP_TX_P: U6.B4 (MGTPTXP0_216); also elsewhere on the board
SYS_CLK: U6.V4 (IO_L12P_T1_MRCC_34); also elsewhere on the board

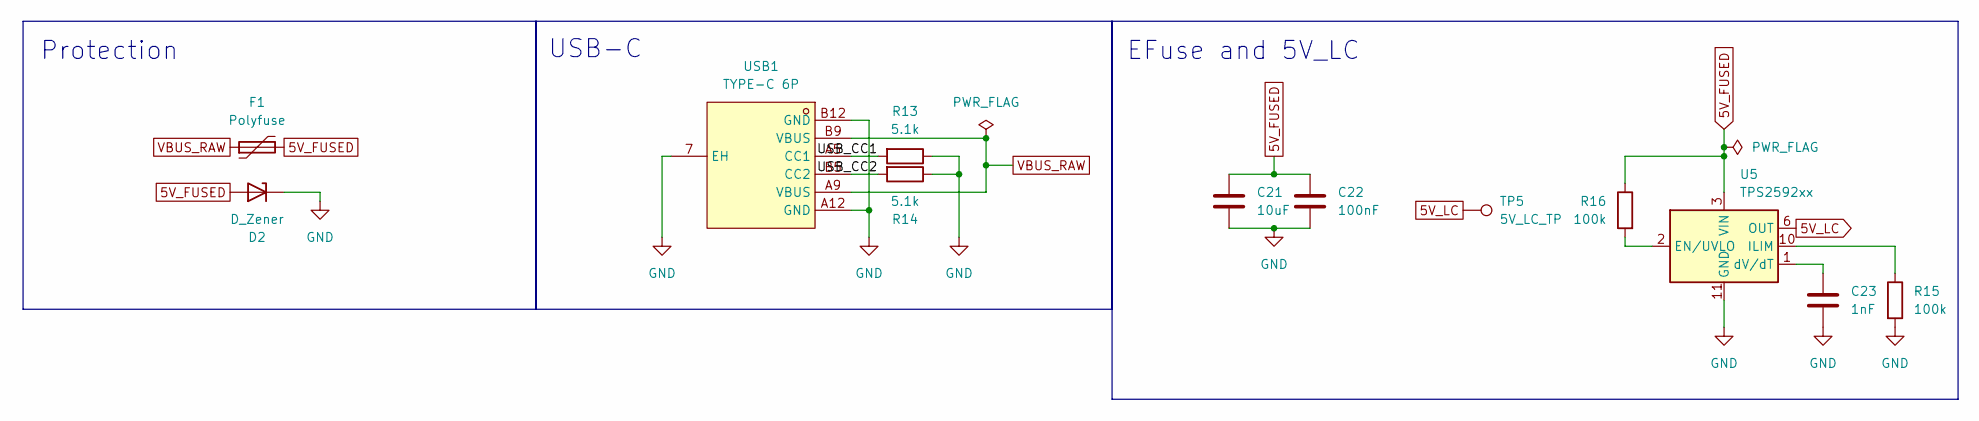
[picture p7: schematic powerin.kicad_sch]

Parts:
C21: 10uF; CP_Radial_D5.0mm_P2.00mm; LCSC Part C47344176
C22: 100nF; C_Disc_D3.0mm_W2.0mm_P2.50mm; LCSC Part C5632430
C23: 1nF; C_Disc_D3.0mm_W2.0mm_P2.50mm; LCSC Part C1624895
D2: D_Zener; D_DO-41_SOD81_P10.16mm_Horizontal
F1: Polyfuse; FUSE-TH_L9.5-W3.5-P5.08-D0.8-S1.2
R13, R14: 5.1k; R_Axial_DIN0207_L6.3mm_D2.5mm_P10.16mm_Horizontal
R15, R16: 100k; R_Axial_DIN0207_L6.3mm_D2.5mm_P10.16mm_Horizontal
TP5: 5V_LC_TP; TestPoint_THTPad_D1.5mm_Drill0.7mm
U5: TPS2592xx; VSON-10-1EP_3x3mm_P0.5mm_EP1.65x2.4mm; LCSC Part C527680
USB1: TYPE-C 6P; TYPE-C-SMD_TYPE-C-6P_1; MPN TYPE-C 6P; LCSC Part C456012

Connections:
5V_FUSED: C21.1, C22.1, D2.2 (A), F1.2, R16.1, U5.3 (VIN), U5.4 (VIN), U5.5 (VIN)
5V_LC: TP5.1 (1_1), U5.6 (OUT), U5.7 (OUT), U5.8 (OUT); also elsewhere on the board
/PowerIn/USB_CC1: R13.2, USB1.A5 (CC1)
/PowerIn/USB_CC2: R14.2, USB1.B5 (CC2)
GND: C21.2, C22.2, C23.2, D2.1 (K), R13.1, R14.1, R15.2, U5.11 (GND), USB1.7 (EH), USB1.A12 (GND), USB1.B12 (GND); also elsewhere on the board
unnamed: R16.2, U5.2 (EN/UVLO)
unnamed: R15.1, U5.10 (ILIM)
unnamed: C23.1, U5.1 (dV/dT)
VBUS_RAW: F1.1, USB1.A9 (VBUS), USB1.B9 (VBUS)

Notes on the sheet:
USB-C
Protection
EFuse and 5V_LC
