aakashvishcoder/fpgacarrierboard/fpgacarrierboard.kicad_pcb

## KiCad design fpgacarrierboard.kicad_pcb (continued)

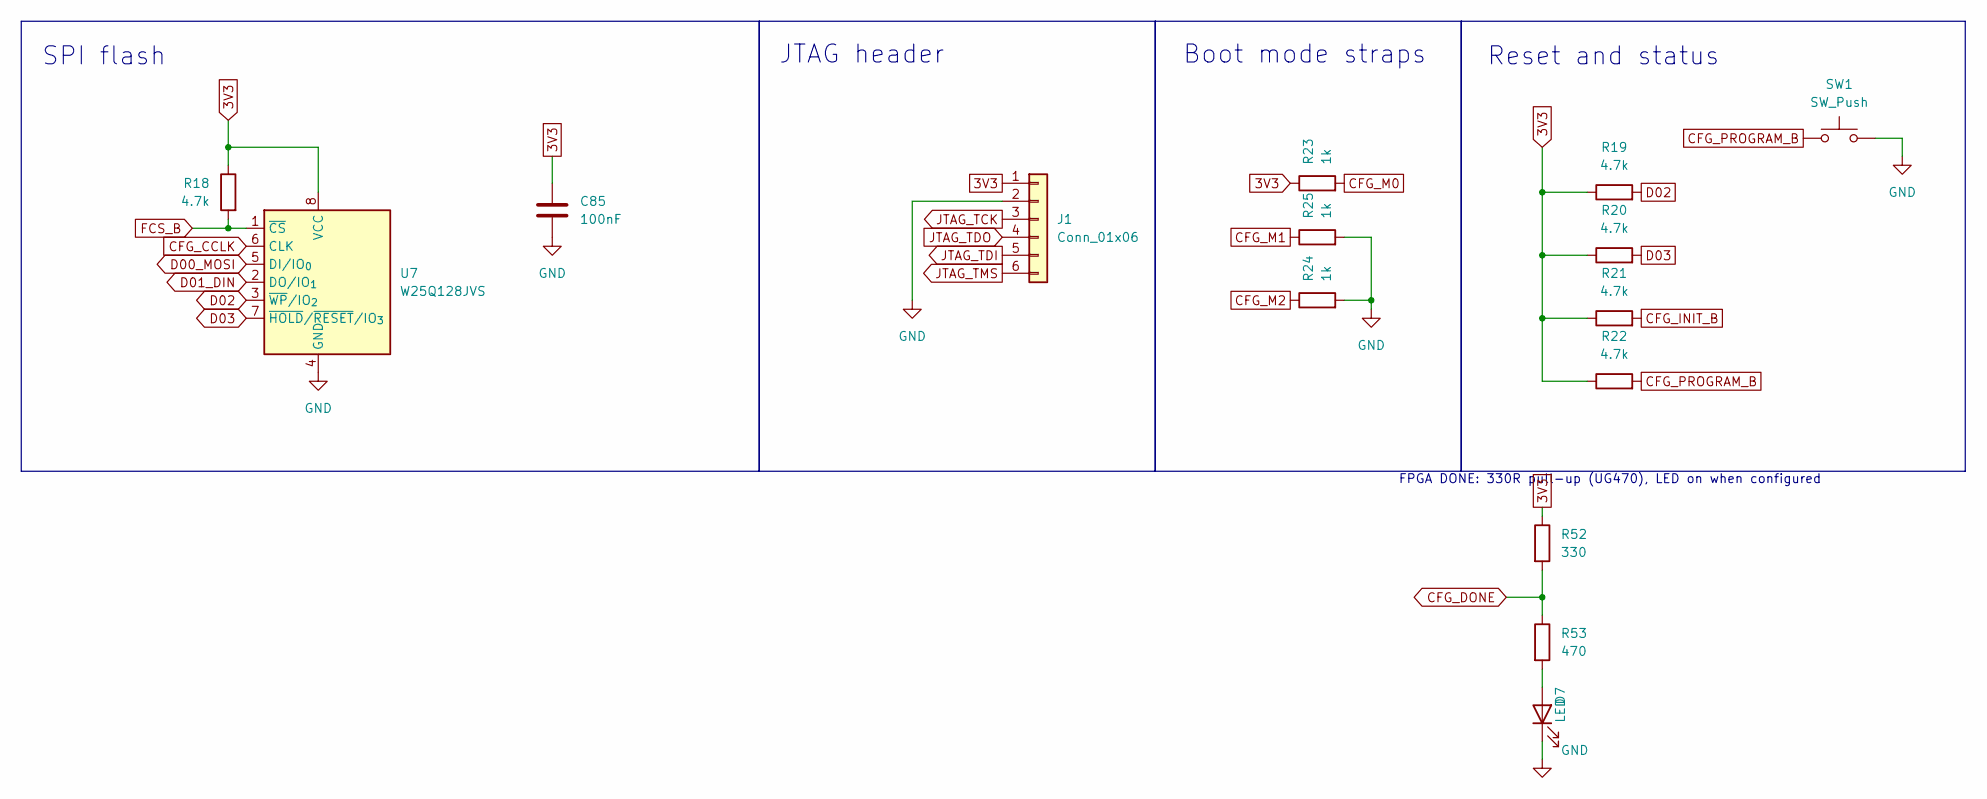
[picture p8: schematic config_jtag.kicad_sch]

Parts:
C85: 100nF; C_Disc_D3.0mm_W2.0mm_P2.50mm; LCSC Part C5632430
D7: LED; LED_D3.0mm
J1: Conn_01x06; PinHeader_1x06_P2.54mm_Vertical
R18, R19, R20, R21, R22: 4.7k; R_Axial_DIN0207_L6.3mm_D2.5mm_P10.16mm_Horizontal
R23, R24, R25: 1k; R_Axial_DIN0207_L6.3mm_D2.5mm_P10.16mm_Horizontal
R52: 330; R_Axial_DIN0207_L6.3mm_D2.5mm_P10.16mm_Horizontal
R53: 470; R_Axial_DIN0207_L6.3mm_D2.5mm_P10.16mm_Horizontal
SW1: SW_Push; SW_SPST_TL3342
U7: W25Q128JVS; SOIC-8_5.3x5.3mm_P1.27mm; LCSC Part C97521

Connections:
3V3: C85.1, J1.1, R18.1, R19.1, R20.1, R21.1, R22.1, R23.1, R52.1, U7.8 (VCC); also elsewhere on the board
CFG_CCLK: U7.6 (CLK); also elsewhere on the board
CFG_DONE: R52.2, R53.1; also elsewhere on the board
CFG_INIT_B: R21.2; also elsewhere on the board
CFG_M0: R23.2; also elsewhere on the board
CFG_M1: R25.1; also elsewhere on the board
CFG_M2: R24.1; also elsewhere on the board
CFG_PROGRAM_B: R22.2, SW1.1; also elsewhere on the board
D00_MOSI: U7.5 (DI/IO_{0}); also elsewhere on the board
D01_DIN: U7.2 (DO/IO_{1}); also elsewhere on the board
D02: R19.2, U7.3 (~WP/IO_{2}); also elsewhere on the board
D03: R20.2, U7.7 (~HOLD/~RESET/IO_{3}); also elsewhere on the board
FCS_B: R18.2, U7.1 (~CS); also elsewhere on the board
GND: C85.2, D7.1 (K), J1.2, R24.2, R25.2, SW1.2, U7.4 (GND); also elsewhere on the board
JTAG_TCK: J1.3; also elsewhere on the board
JTAG_TDI: J1.5; also elsewhere on the board
JTAG_TDO: J1.4; also elsewhere on the board
JTAG_TMS: J1.6; also elsewhere on the board
unnamed: D7.2 (A), R53.2

Notes on the sheet:
Reset and status
SPI flash
JTAG header
Boot mode straps
FPGA DONE: 330R pull-up (UG470), LED on when configured

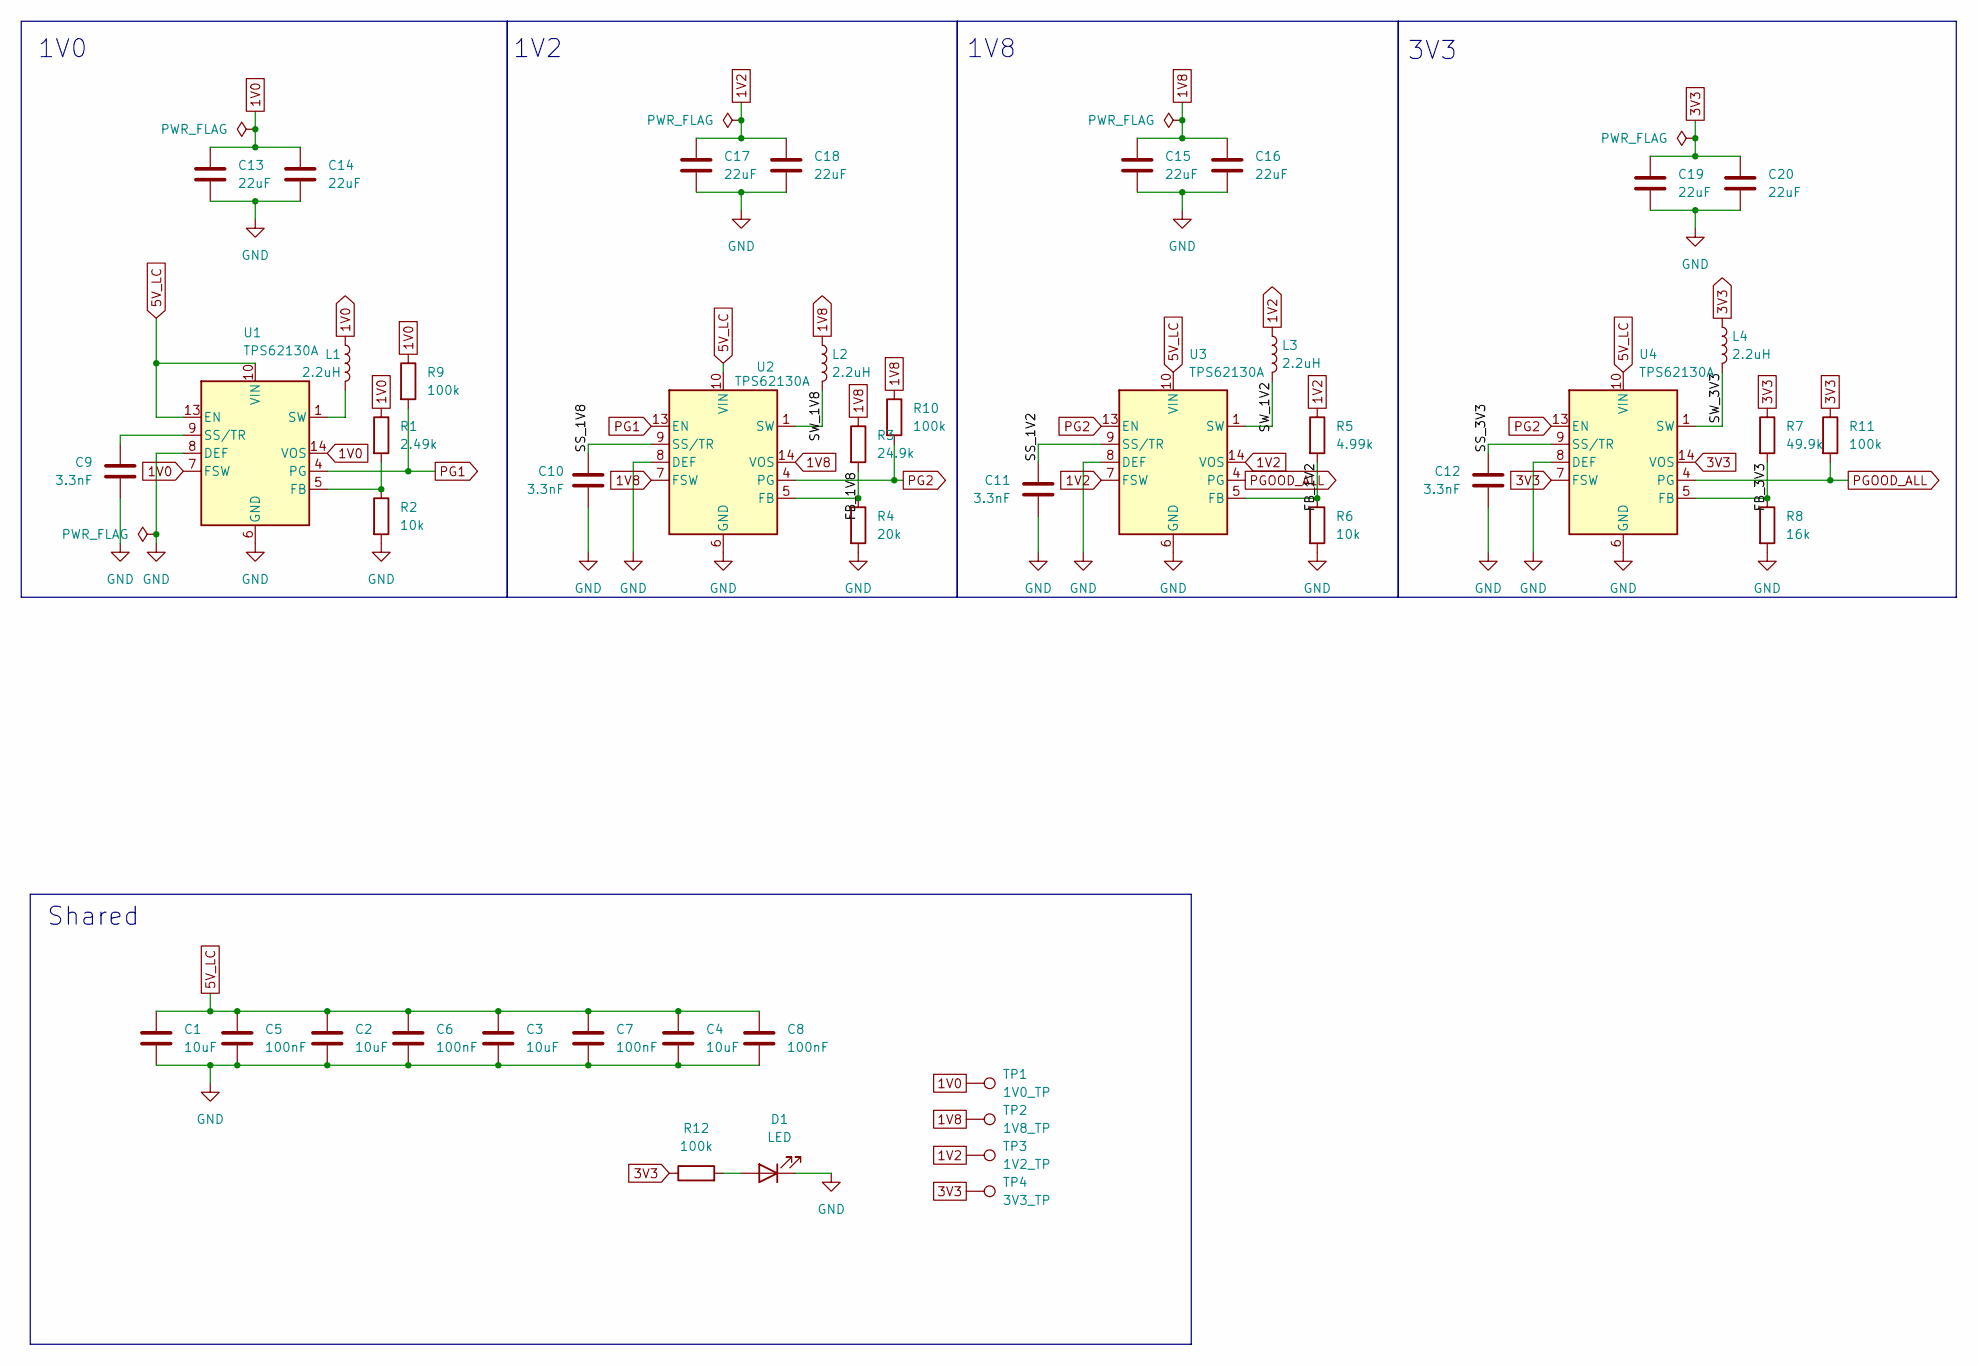
[picture p9: schematic powerrails.kicad_sch]

Parts:
C1, C2, C3, C4: 10uF; CP_Radial_D5.0mm_P2.00mm; LCSC Part C47344176
C5, C6, C7, C8: 100nF; C_Disc_D3.0mm_W2.0mm_P2.50mm; LCSC Part C5632430
C9, C10, C11, C12: 3.3nF; C_Disc_D3.0mm_W2.0mm_P2.50mm; LCSC Part C511575
C13, C14, C15, C16, C17, C18, C19, C20: 22uF; CP_Radial_D6.3mm_P2.50mm; LCSC Part C2835673
D1: LED; LED_D3.0mm
L1, L2, L3, L4: 2.2uH; IND-SMD_L4.5-W4.1_SRP4020TA; LCSC Part C719179
R1: 2.49k; R_Axial_DIN0207_L6.3mm_D2.5mm_P10.16mm_Horizontal
R2, R6: 10k; R_Axial_DIN0207_L6.3mm_D2.5mm_P10.16mm_Horizontal
R3: 24.9k; R_Axial_DIN0207_L6.3mm_D2.5mm_P10.16mm_Horizontal
R4: 20k; R_Axial_DIN0207_L6.3mm_D2.5mm_P10.16mm_Horizontal
R5: 4.99k; R_Axial_DIN0207_L6.3mm_D2.5mm_P10.16mm_Horizontal
R7: 49.9k; R_Axial_DIN0207_L6.3mm_D2.5mm_P10.16mm_Horizontal
R8: 16k; R_Axial_DIN0207_L6.3mm_D2.5mm_P10.16mm_Horizontal
R9, R10, R11, R12: 100k; R_Axial_DIN0207_L6.3mm_D2.5mm_P10.16mm_Horizontal
TP1: 1V0_TP; TestPoint_THTPad_D1.5mm_Drill0.7mm
TP2: 1V8_TP; TestPoint_THTPad_D1.5mm_Drill0.7mm
TP3: 1V2_TP; TestPoint_THTPad_D1.5mm_Drill0.7mm
TP4: 3V3_TP; TestPoint_THTPad_D1.5mm_Drill0.7mm
U1, U2, U3, U4: TPS62130A; VQFN-16-1EP_3x3mm_P0.5mm_EP1.68x1.68mm; LCSC Part C337502

Connections:
1V0: C13.1, C14.1, L1.1, R1.1, R9.1, TP1.1 (1_1), U1.7 (FSW), U1.14 (VOS); also elsewhere on the board
1V2: C17.1, C18.1, L3.1, R5.1, TP3.1 (1_1), U3.7 (FSW), U3.14 (VOS); also elsewhere on the board
1V8: C15.1, C16.1, L2.1, R3.1, R10.1, TP2.1 (1_1), U2.7 (FSW), U2.14 (VOS); also elsewhere on the board
3V3: C19.1, C20.1, L4.1, R7.1, R11.1, R12.1, TP4.1 (1_1), U4.7 (FSW), U4.14 (VOS); also elsewhere on the board
5V_LC: C1.1, C2.1, C3.1, C4.1, C5.1, C6.1, C7.1, C8.1, U1.10 (VIN), U1.11 (VIN), U1.12 (VIN), U1.13 (EN), U2.10 (VIN), U2.11 (VIN), U2.12 (VIN), U3.10 (VIN), U3.11 (VIN), U3.12 (VIN), U4.10 (VIN), U4.11 (VIN), U4.12 (VIN); also elsewhere on the board
/Power_Rails/FB_1V2: R5.2, R6.1, U3.5 (FB)
/Power_Rails/FB_1V8: R3.2, R4.1, U2.5 (FB)
/Power_Rails/FB_3V3: R7.2, R8.1, U4.5 (FB)
/Power_Rails/SS_1V2: C11.1, U3.9 (SS/TR)
/Power_Rails/SS_1V8: C10.1, U2.9 (SS/TR)
/Power_Rails/SS_3V3: C12.1, U4.9 (SS/TR)
/Power_Rails/SW_1V2: L3.2, U3.1 (SW), U3.2 (SW), U3.3 (SW)
/Power_Rails/SW_1V8: L2.2, U2.1 (SW), U2.2 (SW), U2.3 (SW)
/Power_Rails/SW_3V3: L4.2, U4.1 (SW), U4.2 (SW), U4.3 (SW)
GND: C1.2, C2.2, C3.2, C4.2, C5.2, C6.2, C7.2, C8.2, C9.2, C10.2, C11.2, C12.2, C13.2, C14.2, C15.2, C16.2, C17.2, C18.2, C19.2, C20.2, D1.1 (K), R2.2, R4.2, R6.2, R8.2, U1.6 (GND), U1.8 (DEF), U1.15 (GND), U1.16 (GND), U1.17 (GND), U2.6 (GND), U2.8 (DEF), U2.15 (GND), U2.16 (GND), U2.17 (GND), U3.6 (GND), U3.8 (DEF), U3.15 (GND), U3.16 (GND), U3.17 (GND), U4.6 (GND), U4.8 (DEF), U4.15 (GND), U4.16 (GND), U4.17 (GND); also elsewhere on the board
unnamed: D1.2 (A), R12.2
unnamed: L1.2, U1.1 (SW), U1.2 (SW), U1.3 (SW)
unnamed: R1.2, R2.1, U1.5 (FB)
unnamed: C9.1, U1.9 (SS/TR)
PG1: R9.2, U1.4 (PG), U2.13 (EN)
PG2: R10.2, U2.4 (PG), U3.13 (EN), U4.13 (EN)
PGOOD_ALL: R11.2, U3.4 (PG), U4.4 (PG)

Notes on the sheet:
1V8
3V3
1V0
1V2
Shared

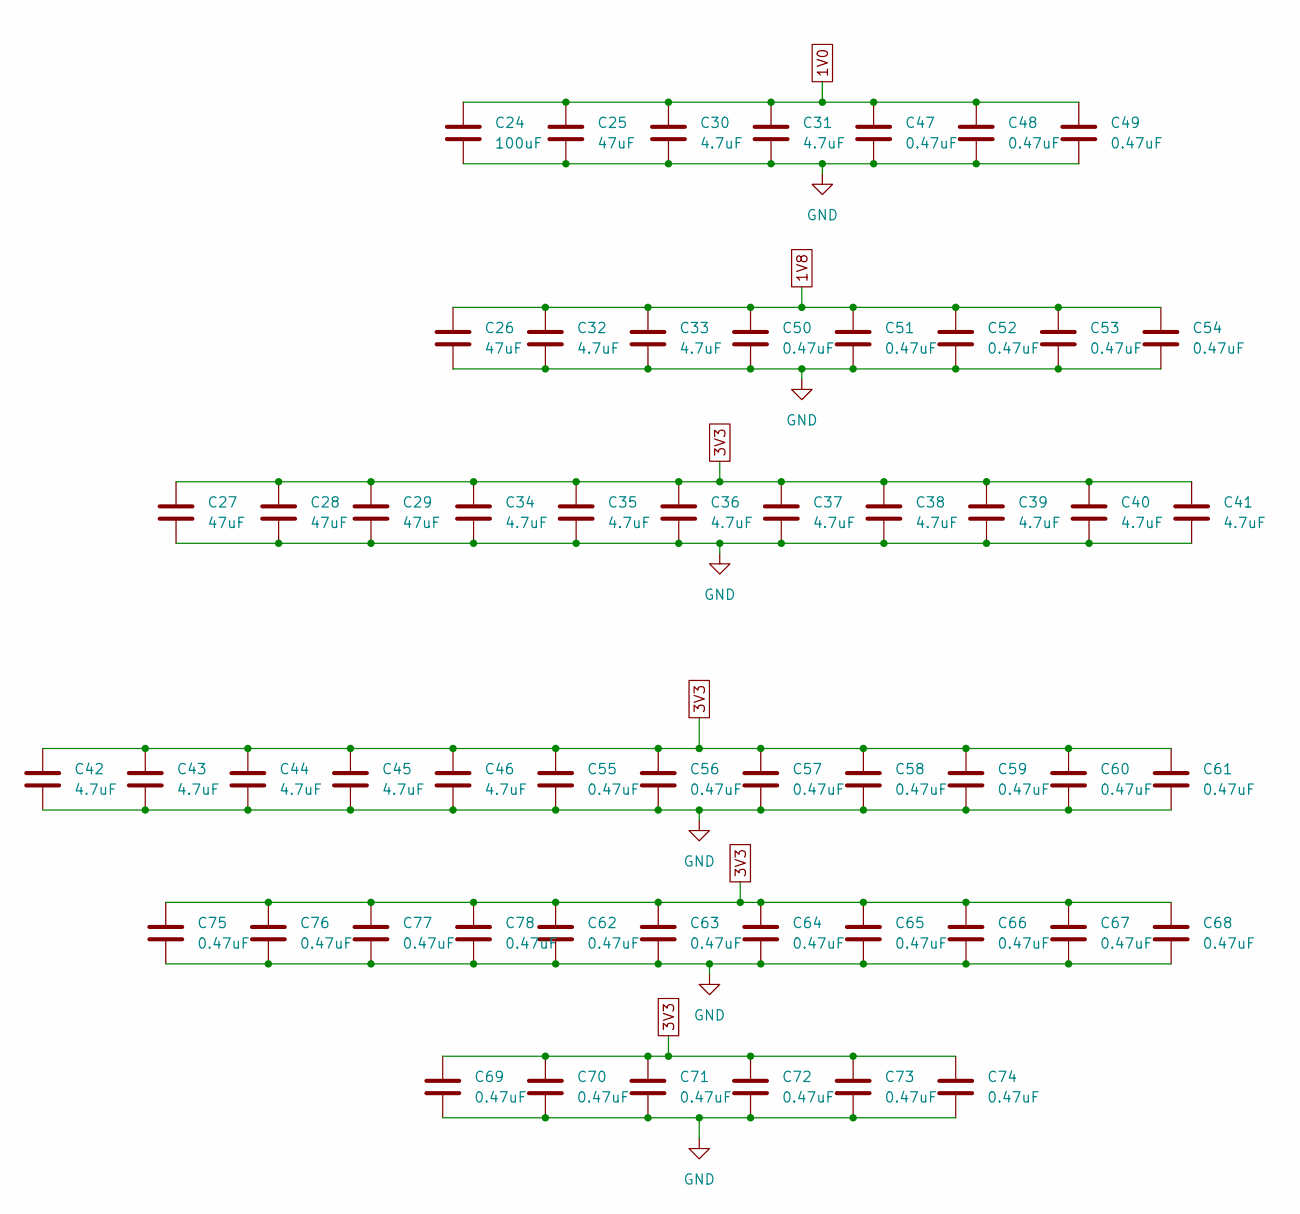
[picture p10: schematic dcapacitors.kicad_sch]

Parts:
C24: 100uF; C_1210_3225Metric; LCSC Part C49066
C25, C26, C27, C28, C29: 47uF; C_1210_3225Metric; LCSC Part C2932477
C30, C31, C32, C33, C34, C35, C36, C37, C38, C39, C40, C41, C42, C43, C44, C45, C46: 4.7uF; C_0805_2012Metric; LCSC Part C98195
C47, C48, C49, C50, C51, C52, C53, C54, C55, C56, C57, C58, C59, C60, C61, C62, C63, C64, C65, C66, C67, C68, C69, C70, C71, C72, C73, C74, C75, C76, C77, C78: 0.47uF; C_0603_1608Metric; LCSC Part C1623

Connections:
1V0: C24.1, C25.1, C30.1, C31.1, C47.1, C48.1, C49.1; also elsewhere on the board
1V8: C26.1, C32.1, C33.1, C50.1, C51.1, C52.1, C53.1, C54.1; also elsewhere on the board
3V3: C27.1, C28.1, C29.1, C34.1, C35.1, C36.1, C37.1, C38.1, C39.1, C40.1, C41.1, C42.1, C43.1, C44.1, C45.1, C46.1, C55.1, C56.1, C57.1, C58.1, C59.1, C60.1, C61.1, C62.1, C63.1, C64.1, C65.1, C66.1, C67.1, C68.1, C69.1, C70.1, C71.1, C72.1, C73.1, C74.1, C75.1, C76.1, C77.1, C78.1; also elsewhere on the board
GND: C24.2, C25.2, C26.2, C27.2, C28.2, C29.2, C30.2, C31.2, C32.2, C33.2, C34.2, C35.2, C36.2, C37.2, C38.2, C39.2, C40.2, C41.2, C42.2, C43.2, C44.2, C45.2, C46.2, C47.2, C48.2, C49.2, C50.2, C51.2, C52.2, C53.2, C54.2, C55.2, C56.2, C57.2, C58.2, C59.2, C60.2, C61.2, C62.2, C63.2, C64.2, C65.2, C66.2, C67.2, C68.2, C69.2, C70.2, C71.2, C72.2, C73.2, C74.2, C75.2, C76.2, C77.2, C78.2; also elsewhere on the board

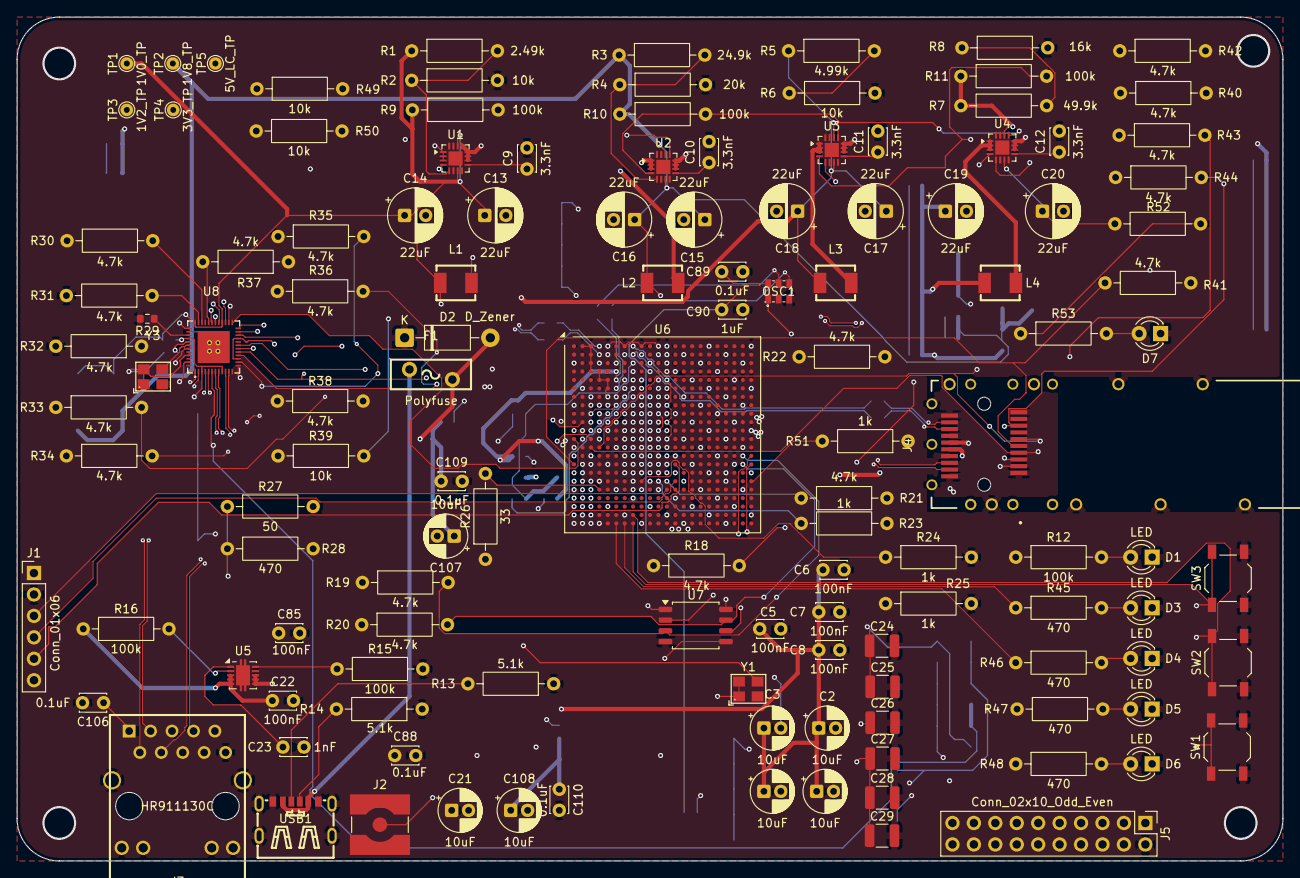
[picture p11: board fpgacarrierboard.kicad_pcb from above]

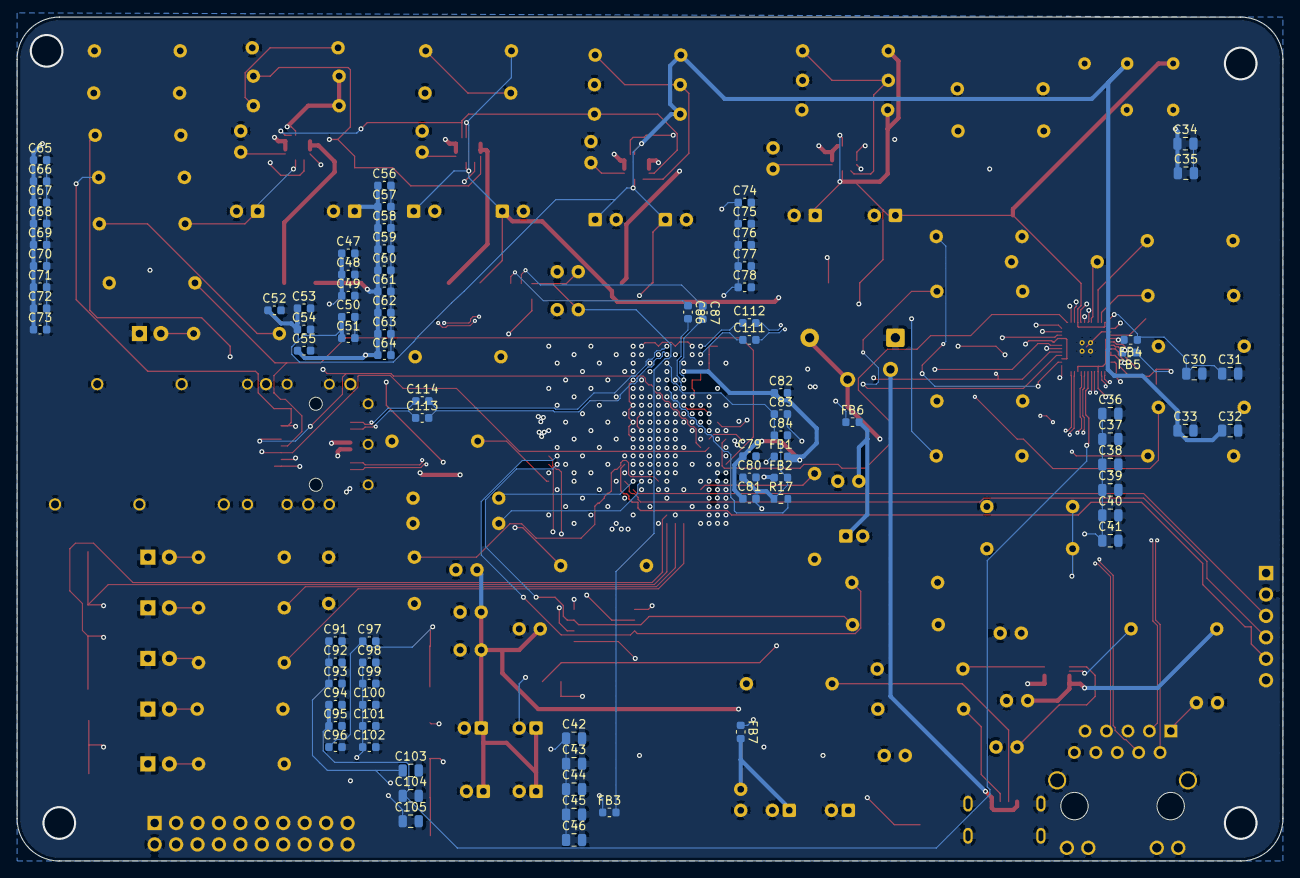
[picture p12: board fpgacarrierboard.kicad_pcb from below]

Board: 6 copper layers, 150.0 x 100.0 mm, 211 parts (84 on the bottom side), 134 nets.
