aakashvishcoder/fpgacarrierboard/(commit log)

2026-09-27 Initial commit: FPGA carrier board schematic, ERC-clean, BOM complete
    [bom_cli.csv, bom_final.csv, clocks.kicad_sch, config_jtag.kicad_sch, dcapacitors.kicad_sch, ethernet1g.kicad_sch, fpgacarrierboard.csv, fpgacarrierboard.kicad_pcb]
2026-09-27 Add LCSC Basic/Extended part numbers for JLC-placed passives and ferrite beads
    [bom_cli.csv, bom_final.csv, clocks.kicad_sch, dcapacitors.kicad_sch, ethernet1g.kicad_sch, fpgacore.kicad_sch, sfplane.kicad_sch]
2026-10-09 Add optional ESP32-C3 WiFi sheet, convert hand-solder parts to through-hole
    - New wifi sheet: ESP32-C3-MINI-1 module on SPI to spare FPGA bank 34, with EN/boot-strap networks, 3V3 bypass/bulk caps and a UART debug header
    - Replace SMD hand-solder resistors, LEDs, zener, fuse and ceramic caps with THT equivalents; bulk 10uF/22uF caps become polarized electrolytics
    - Fill in LCSC part numbers for the new parts and regenerate BOM and ERC report
    [bom_cli.csv, bom_final.csv, clocks.kicad_sch, config_jtag.kicad_sch, dcapacitors.kicad_sch, ethernet1g.kicad_sch, fpgacarrierboard.kicad_sch, fpgacore.kicad_sch]
2026-10-09 Start PCB layout: 6-layer stackup, component placement, footprint fixes
    - Set 6-layer JLC-style physical stackup and place all components in the 150x100mm outline
    - Fix U8 thermal vias (pad 49 on GND), J3 mounting holes (NPTH) and J4 keepouts
    - Ignore KiCad local-history restore backups
    [fpgacarrierboard.kicad_pcb]
2026-10-09 Board setup: JLC design rules, net classes, ENIG finish
    [fpgacarrierboard.kicad_pcb]
2026-10-09 Remove optional WiFi sheet from schematic and PCB
    - Delete wifi sheet and its seven parts; restore no-connect flags on the five freed FPGA bank-34 pins
    - Reduce J4 pad solder-mask margin so the fine-pitch pads meet the 0.1mm web rule
    - Regenerate BOM and ERC report
    [bom_cli.csv, bom_final.csv, fpgacarrierboard.kicad_pcb, fpgacarrierboard.kicad_sch, fpgacore.kicad_sch, wifi.kicad_sch]
2026-10-09 Pre-routing checkpoint: zone pours, net labels, decoupling on bottom, R51 1k
    - GND pours on F.Cu, In1.Cu, In4.Cu, B.Cu; In3.Cu power pours for 1V0, 1V8,
    5V_LC, MGTAVCC, MGTAVTT, 3V3 (3V3 lowest priority)
    - Local labels on previously unnamed power nets
    - FPGA decoupling moved to B.Cu under/around U6
    - R51 (PUDC_B pull-up) 4.7k -> 1k per UG470
    - Silkscreen cleanup
    [clocks.kicad_sch, ethernet1g.kicad_sch, fpgacarrierboard.kicad_pcb, fpgacore.kicad_sch, iobreakout.kicad_sch, powerin.kicad_sch, powerrails.kicad_sch]
2026-10-16 Routing in progress: In3 power pours, DONE LED, DRC cleanup
    - Add CFG_DONE 330R pull-up (R52) and DONE LED (D7, R53) per UG470
    - Redraw In3.Cu pours to sit under their U6 balls (1V0 core, 1V8 strip,
    MGTAVCC, MGTAVTT); trim 5V_LC strip to y=50; zone clearance 0.2mm
    - Remove 3V3/5V_LC traces from In4.Cu GND plane
    - Custom rules: U6 BGA escape, solid GND on regulators/tight caps,
    1-spoke thermals on J4 and C22
    - Fix clearance violations, remove dangling vias and stubs
    - Remaining: GND pours split on In1.Cu/B.Cu by signal traces on In1.Cu
    [config_jtag.kicad_sch, fpgacarrierboard.kicad_pcb, fpgacore.kicad_sch, powerrails.kicad_sch]
2026-10-16 Move signals off GND planes where they fit, stitch cut-off GND pieces
    - In1.Cu: move 16 nets (62 segments) to In2.Cu/B.Cu where they fit with
    no clashes; 213 segments remain on In1.Cu
    - In4.Cu: move 7 nets (54 segments) to In3.Cu/In2.Cu/B.Cu; BTN0, BTN1,
    1V0, 1V8, PHY_AVDD10 remain on In4.Cu
    - Add GND stitching vias in cut-off In1.Cu, In4.Cu and B.Cu pieces
    - Remove redundant SFP_VCCT via
    - Known issue: C81, C83, C84 GND pads sit in B.Cu islands with no via
    [fpgacarrierboard.kicad_pcb]
2026-10-16 As-ordered: fab outputs, JLC BOM/CPL, hand-solder BOM
    - Gerbers and drill files (gerbers/), 6-layer, matching board saved 00:32
    - bom_jlc.csv / gerbers/fpgacarrierboard-BOM.csv: 109 SMD parts for JLC
    - gerbers/fpgacarrierboard-CPL.csv: placement for the same 109 parts
    - bom_handsolder.csv: 97 through-hole parts plus SW1-SW3
    - DRC: 0 errors, 0 unconnected, parity clean
    [bom_handsolder.csv, bom_jlc.csv, fpgacarrierboard-BOM.csv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]
